binkul/Atari_130XE_1MB_SpartaDosX_SIO2SD/README.md

# Atari 130XE with 1MB simm expansion + Internal Sparta Dos X 64 kb + SIO2SD internal
## In folder '1 MB Extension' - schematic + jedec file for GAL 20V8
## In folder 'OS 29C512 or 29F010' - memory contents for Flash 29C512 or 29F010 => four OS (Atari 130XE 2x and Bibo OS 2x)
## In folder 'SD Card' - everything to run inregnal SD card. Read cerafully http://sio2sd.org/pl/index.html or similar
## In folder 'Sparta 64KB' - everything to program GAL 20V8 and Flash 29C512 or 29F010
