binkul/Atari_130XE_1MB_SpartaDosX_SIO2SD/1 MB Extension/simmexp.gif

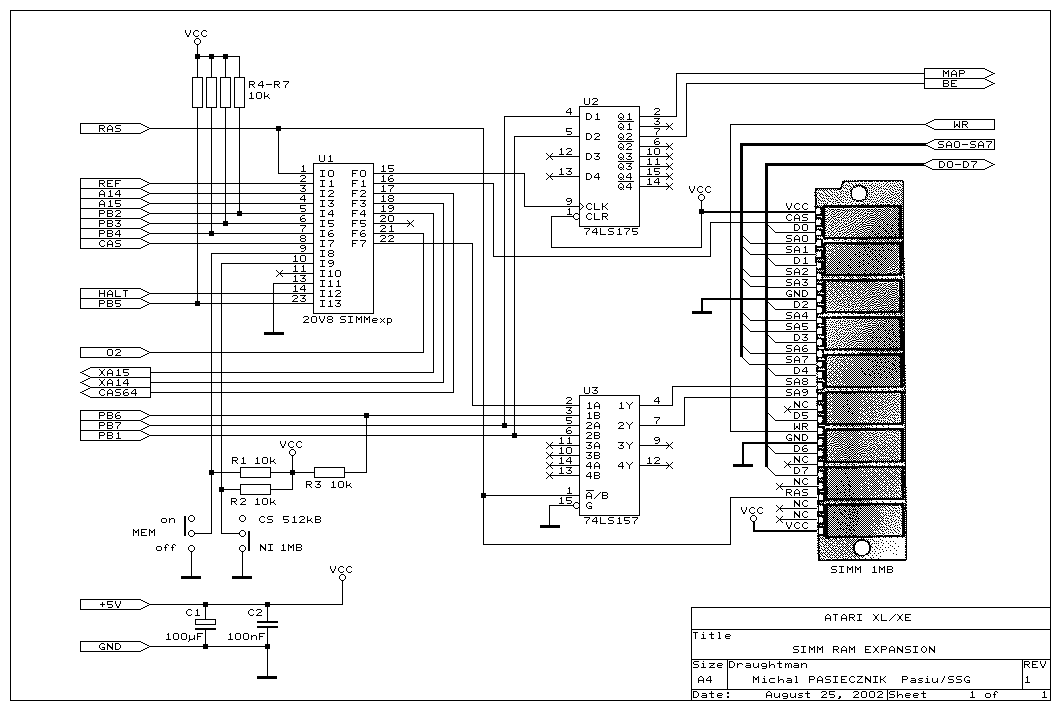
1 MB Extension/simmexp.gif
