binkul/Atari_130XE_1MB_SpartaDosX_SIO2SD/Sparta 64KB/intsdxv11.gif

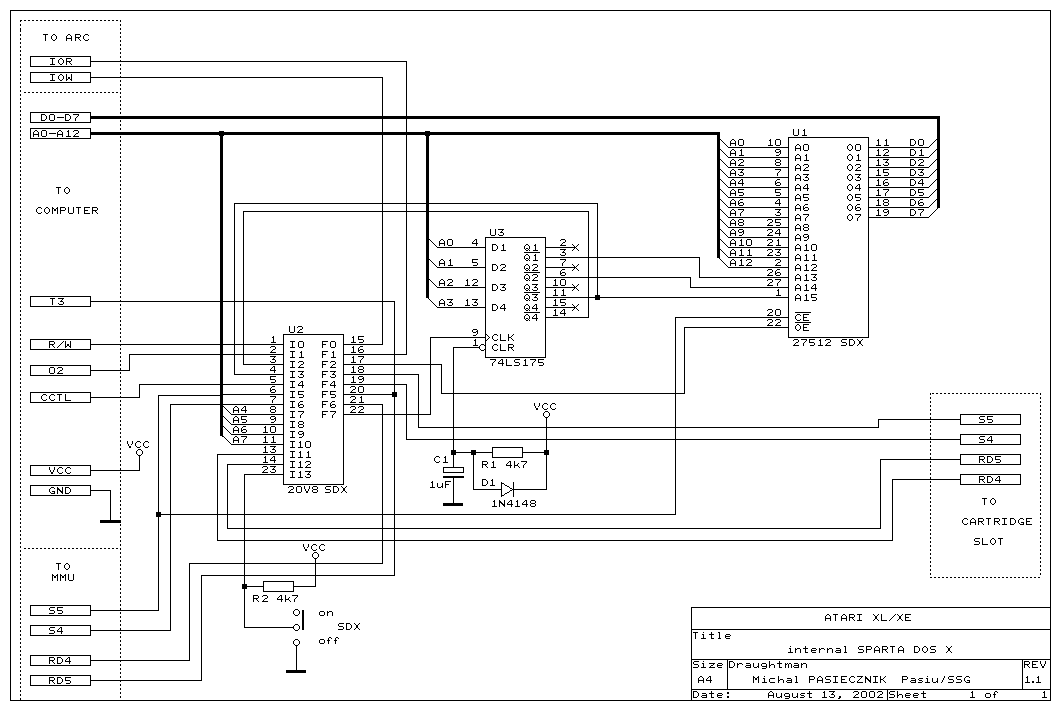
Sparta 64KB/intsdxv11.gif
