binkul/Atari_130XE_1MB_SpartaDosX_SIO2SD/Atari 130XE 1MB Sparta.kicad_pcb

## KiCad design Atari 130XE 1MB Sparta.kicad_pcb (2023-07-16)

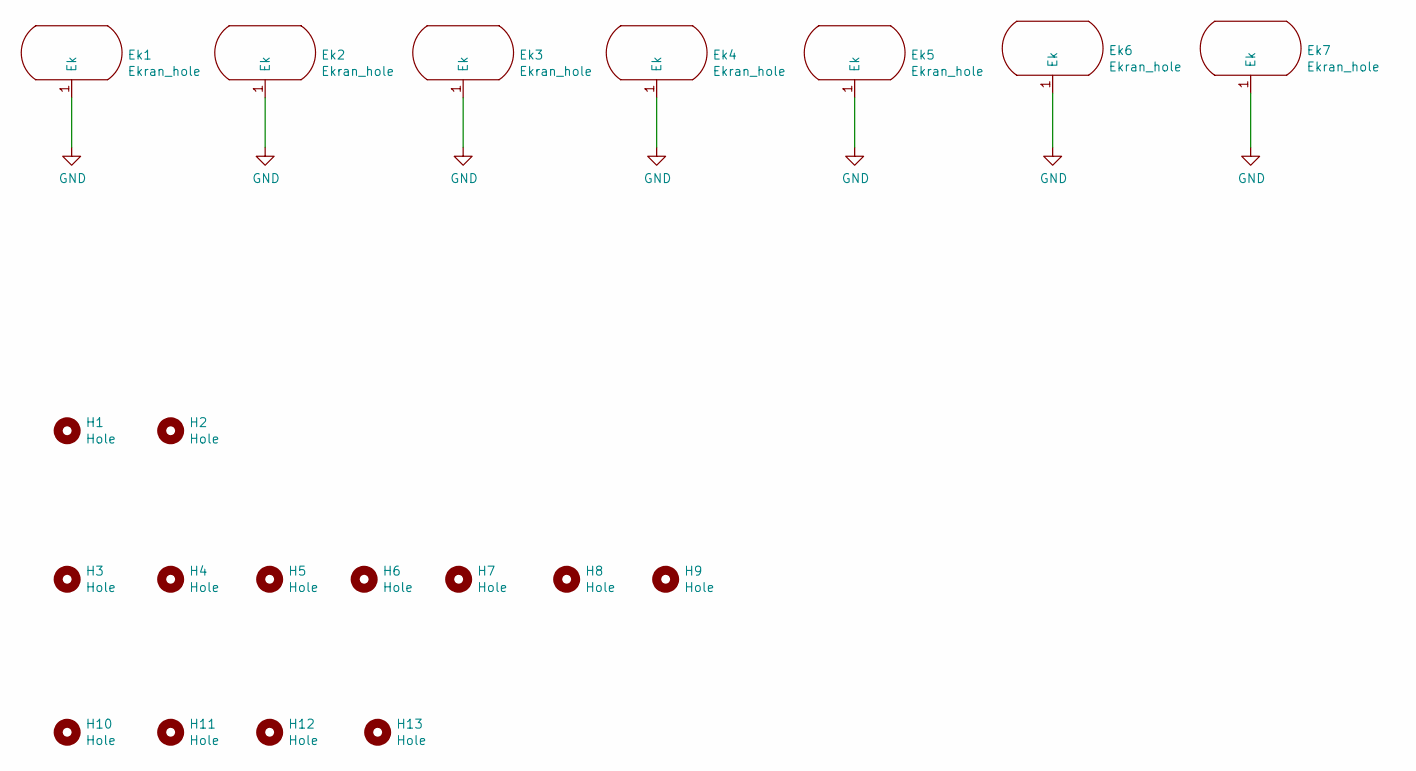
[picture p3: schematic Holes.sch]

Parts:
Ek1, Ek2, Ek3, Ek4, Ek5, Ek6, Ek7: Ekran_hole; Ekran_GND
H1, H2: Hole; Medium_hole
H3, H4, H5, H6, H7, H8, H9: Hole; Hole_3.4mm
H10, H11, H12, H13: Hole; Hole_4.4mm

Connections:
GND: Ek1.1, Ek2.1, Ek3.1, Ek4.1, Ek5.1, Ek6.1, Ek7.1; also elsewhere on the board

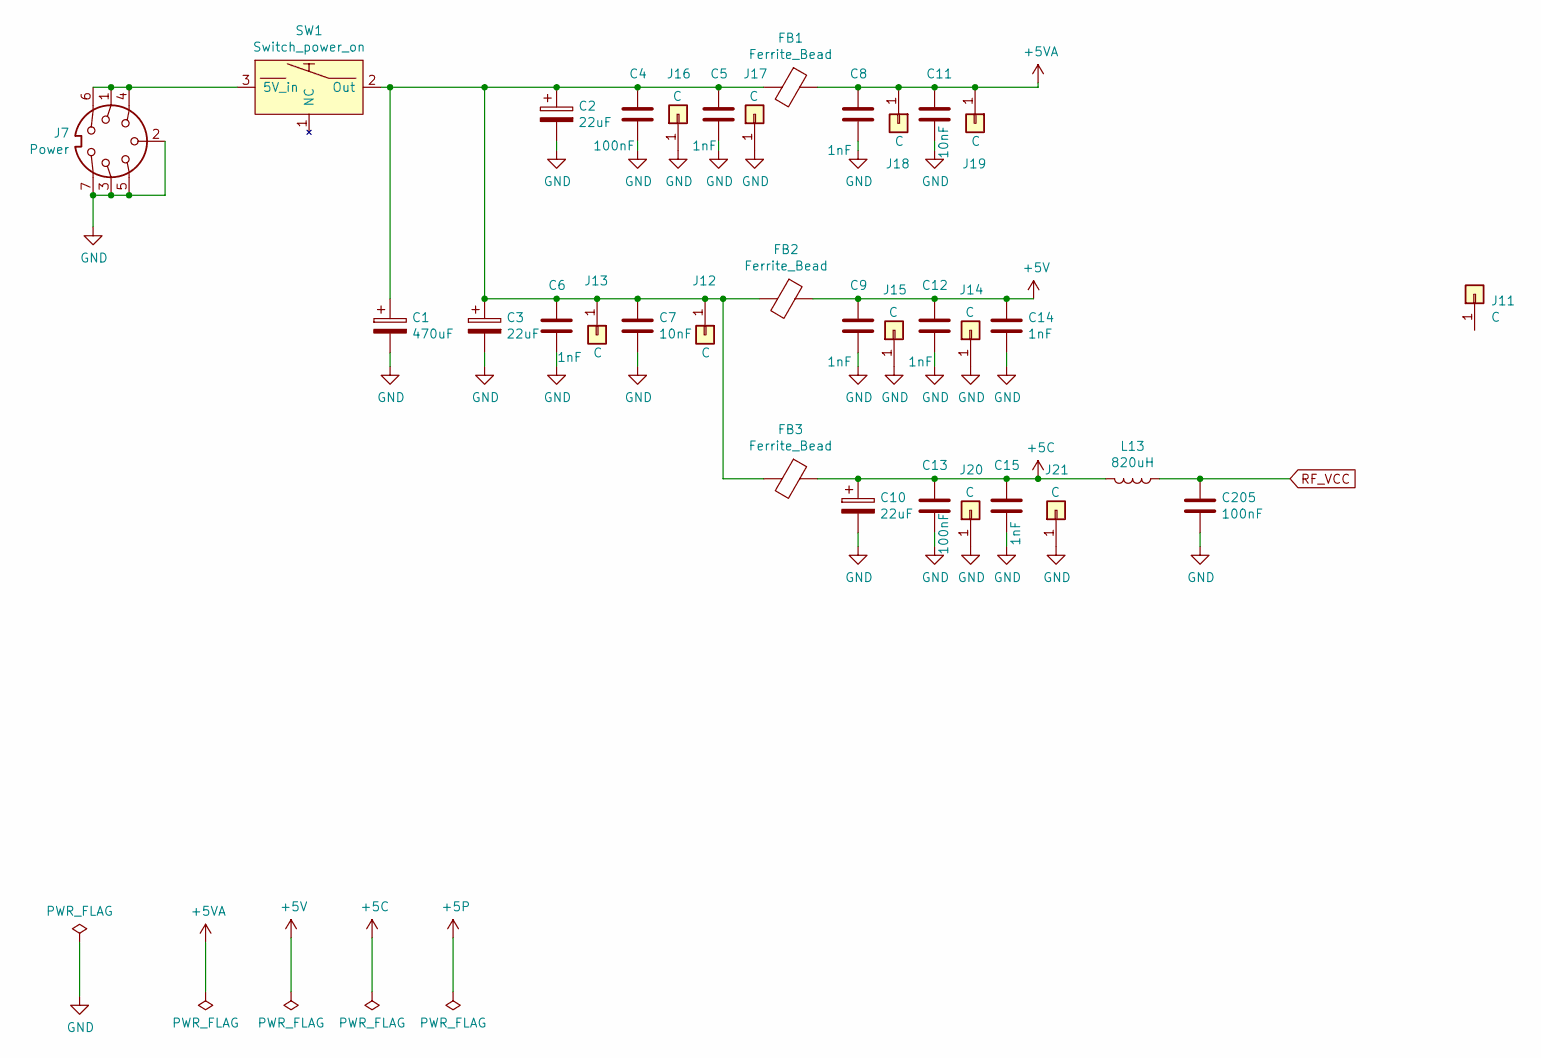
[picture p4: schematic Power.sch]

Parts:
C1: 470uF; CP_Radial_D8.0mm_P3.80mm
C2, C3, C10: 22uF; CP_Radial_D7.5mm_P2.50mm
C4, C13, C205: 100nF; C_Axial_L5.1mm_D2.5mm_P12.50mm_Horizontal
C5, C6, C8, C9, C12, C14, C15: 1nF; C_Axial_L5.1mm_D2.5mm_P12.50mm_Horizontal
C7, C11: 10nF; C_Axial_L5.1mm_D2.5mm_P12.50mm_Horizontal
FB1, FB2, FB3: Ferrite_Bead; L_Axial_L7.0mm_D3.3mm_P12.50mm_Horizontal_Fastron_MICC
J7: Power; DIN_7_pin
J11, J12, J13, J14, J15, J16, J17, J18, J19, J20, J21: C; PinHeader_1x01_P2.54mm_Vertical
L13: 820uH; L_Axial_L7.0mm_D3.3mm_P12.50mm_Horizontal_Fastron_MICC
SW1: Switch_power_on; Switch_ON-OFF

Connections:
+5C: C10.1, C13.1, C15.1, FB3.1, L13.2; also elsewhere on the board
+5V: C9.1, C12.1, C14.1, FB2.1
+5VA: C8.1, C11.1, FB1.1, J18.1, J19.1; also elsewhere on the board
GND: C1.2, C2.2, C3.2, C4.2, C5.2, C6.2, C7.2, C8.2, C9.2, C10.2, C11.2, C12.2, C13.2, C14.2, C15.2, C205.2, J7.2, J7.3, J7.5, J7.7, J14.1, J15.1, J16.1, J17.1, J20.1, J21.1; also elsewhere on the board
unnamed: C1.1, C2.1, C3.1, C4.1, C5.1, C6.1, C7.1, FB1.2, FB2.2, FB3.2, J12.1, J13.1, SW1.2 (Out)
unnamed: J7.1, J7.4, J7.6, SW1.3 (5V_in)
RF_VCC: C205.1, L13.1

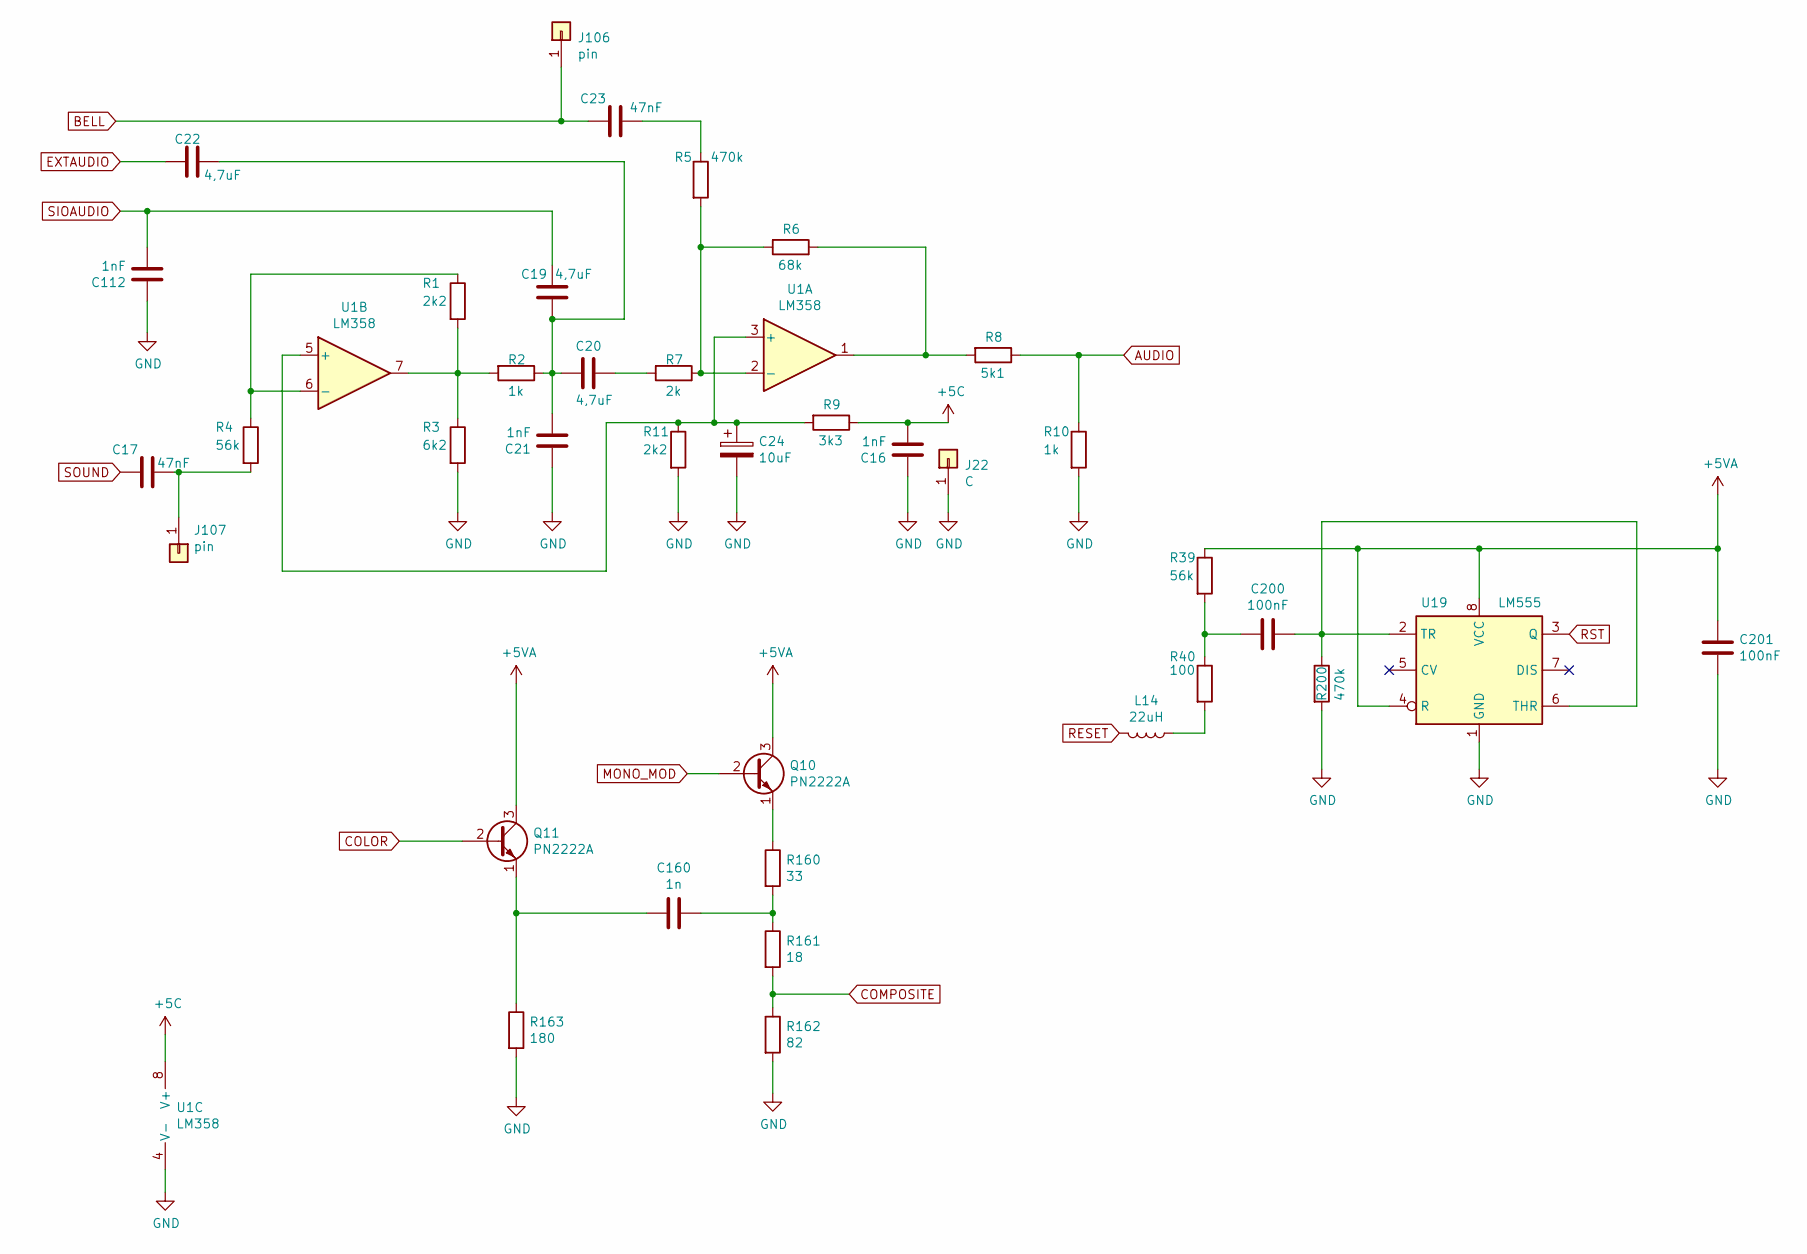
[picture p5: schematic Audio and Video.sch]

Parts:
C16, C21, C112: 1nF; C_Axial_L5.1mm_D2.5mm_P12.50mm_Horizontal
C17, C23: 47nF; C_Axial_L5.1mm_D2.5mm_P12.50mm_Horizontal
C19, C20, C22: 4,7uF; C_Rect_L7.2mm_W7.2mm_P5.00mm_FKS2_FKP2_MKS2_MKP2
C24: 10uF; CP_Radial_D7.5mm_P2.50mm
C160: 1n; C_1206_3216Metric_Pad1.42x1.75mm_HandSolder
C200, C201: 100nF; C_1206_3216Metric_Pad1.42x1.75mm_HandSolder
J22: C; PinHeader_1x01_P2.54mm_Vertical
J106, J107: pin; PinHeader_1x01_P2.00mm_Vertical
L14: 22uH; L_1812_4532Metric_Pad1.30x3.40mm_HandSolder
Q10, Q11: PN2222A; TO-92_Inline
R1, R11: 2k2; R_Axial_DIN0207_L3.6mm_D2.2mm_P10.16mm_Horizontal
R2, R10: 1k; R_Axial_DIN0207_L3.6mm_D2.2mm_P10.16mm_Horizontal
R3: 6k2; R_Axial_DIN0207_L3.6mm_D2.2mm_P10.16mm_Horizontal
R4: 56k; R_Axial_DIN0207_L3.6mm_D2.2mm_P10.16mm_Horizontal
R5: 470k; R_Axial_DIN0207_L3.6mm_D2.2mm_P10.16mm_Horizontal
R6: 68k; R_Axial_DIN0207_L3.6mm_D2.2mm_P10.16mm_Horizontal
R7: 2k; R_Axial_DIN0207_L3.6mm_D2.2mm_P10.16mm_Horizontal
R8: 5k1; R_Axial_DIN0207_L3.6mm_D2.2mm_P10.16mm_Horizontal
R9: 3k3; R_Axial_DIN0207_L3.6mm_D2.2mm_P10.16mm_Horizontal
R39: 56k; R_1206_3216Metric_Pad1.42x1.75mm_HandSolder
R40: 100; R_1206_3216Metric_Pad1.42x1.75mm_HandSolder
R160: 33; R_1206_3216Metric_Pad1.42x1.75mm_HandSolder
R161: 18; R_1206_3216Metric_Pad1.42x1.75mm_HandSolder
R162: 82; R_1206_3216Metric_Pad1.42x1.75mm_HandSolder
R163: 180; R_1206_3216Metric_Pad1.42x1.75mm_HandSolder
R200: 470k; R_1206_3216Metric_Pad1.42x1.75mm_HandSolder
U1: LM358; DIP-8_W7.62mm_Socket
U19: LM555; DIP-8_W7.62mm_Socket

Connections:
+5C: C16.2, R9.1, U1.8 (V+); also elsewhere on the board
+5VA: C201.1, Q10.3 (C), Q11.3 (C), R39.1, U19.4 (R), U19.8 (VCC); also elsewhere on the board
AUDIO: R8.1, R10.1; also elsewhere on the board
BELL: C23.2, J106.1; also elsewhere on the board
COLOR: Q11.2 (B); also elsewhere on the board
COMPOSITE: R161.2, R162.1; also elsewhere on the board
EXTAUDIO: C22.1; also elsewhere on the board
GND: C16.1, C21.1, C24.2, C112.1, C201.2, J22.1, R3.2, R10.2, R11.2, R162.2, R163.2, R200.2, U1.4 (V-), U19.1 (GND); also elsewhere on the board
MONO_MOD: Q10.2 (B); also elsewhere on the board
unnamed: C17.1, J107.1, R4.2
unnamed: C19.1, C20.2, C21.2, C22.2, R2.1
unnamed: C20.1, R7.2
unnamed: C23.1, R5.1
unnamed: C24.1, R9.2, R11.1, U1.3 (+), U1.5 (+)
unnamed: C160.1, R160.2, R161.1
unnamed: C160.2, Q11.1 (E), R163.1
unnamed: C200.1, R200.1, U19.2 (TR), U19.6 (THR)
unnamed: C200.2, R39.2, R40.1
unnamed: L14.1, R40.2
unnamed: Q10.1 (E), R160.1
unnamed: R1.1, R4.1, U1.6 (-)
unnamed: R1.2, R2.2, R3.1, U1.7
unnamed: R5.2, R6.2, R7.1, U1.2 (-)
unnamed: R6.1, R8.2, U1.1
RESET: L14.2; also elsewhere on the board
RST: U19.3 (Q); also elsewhere on the board
SIOAUDIO: C19.2, C112.2; also elsewhere on the board
SOUND: C17.2; also elsewhere on the board

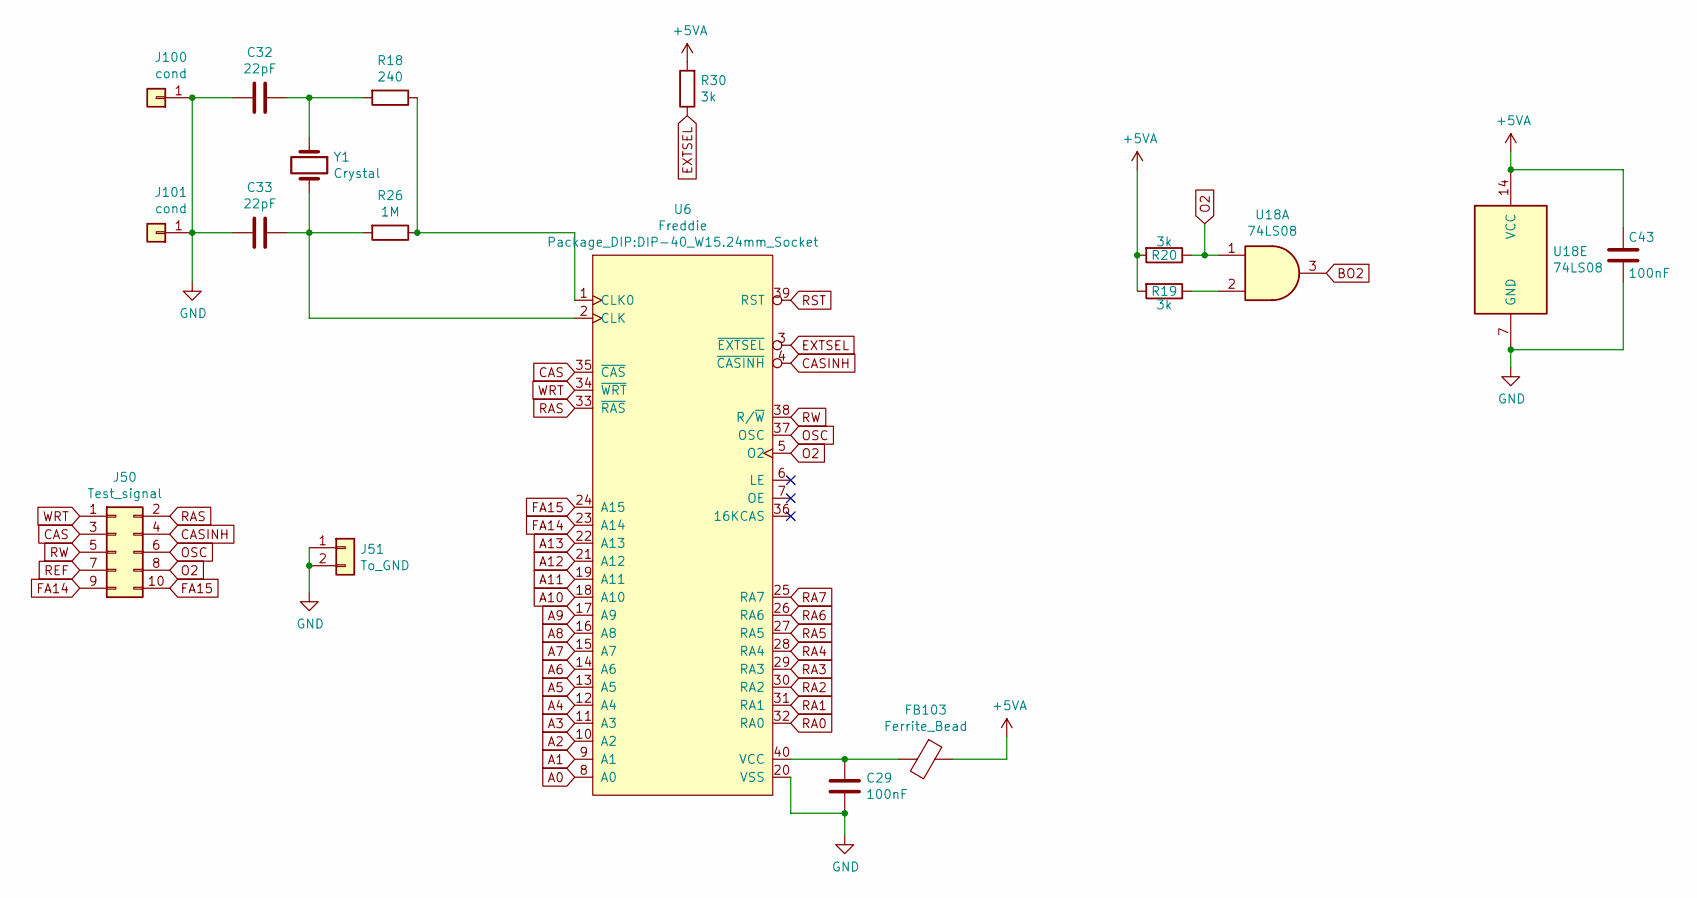
[picture p6: schematic Freddie.sch]

Parts:
C29, C43: 100nF; C_Axial_L5.1mm_D2.5mm_P12.50mm_Horizontal
C32, C33: 22pF; C_Axial_L5.1mm_D2.5mm_P12.50mm_Horizontal
FB103: Ferrite_Bead; L_Axial_L7.0mm_D3.3mm_P12.50mm_Horizontal_Fastron_MICC
J50: Test_signal; PinHeader_2x05_P2.54mm_Vertical
J51: To_GND; PinHeader_1x02_P2.54mm_Vertical
J100, J101: cond; PinHeader_1x01_P2.00mm_Vertical
R18: 240; R_Axial_DIN0207_L6.3mm_D2.5mm_P10.16mm_Horizontal
R19, R20, R30: 3k; R_Axial_DIN0207_L3.6mm_D2.2mm_P10.16mm_Horizontal
R26: 1M; R_Axial_DIN0207_L6.3mm_D2.5mm_P10.16mm_Horizontal
U6: Freddie; DIP-40_W15.24mm_Socket
U18: 74LS08; DIP-14_W7.62mm_Socket
Y1: Crystal; Crystal_HC18-U_Vertical

Connections:
+5VA: C43.1, FB103.1, R19.2, R20.2, R30.2, U18.14 (VCC); also elsewhere on the board
A0: U6.8 (A0); also elsewhere on the board
A1: U6.9 (A1); also elsewhere on the board
A2: U6.10 (A2); also elsewhere on the board
A3: U6.11 (A3); also elsewhere on the board
A4: U6.12 (A4); also elsewhere on the board
A5: U6.13 (A5); also elsewhere on the board
A6: U6.14 (A6); also elsewhere on the board
A7: U6.15 (A7); also elsewhere on the board
A8: U6.16 (A8); also elsewhere on the board
A9: U6.17 (A9); also elsewhere on the board
A10: U6.18 (A10); also elsewhere on the board
A11: U6.19 (A11); also elsewhere on the board
A12: U6.21 (A12); also elsewhere on the board
A13: U6.22 (A13); also elsewhere on the board
BO2: U18.3; also elsewhere on the board
CAS: J50.3, U6.35 (~CAS); also elsewhere on the board
CASINH: J50.4, U6.4 (~CASINH); also elsewhere on the board
EXTSEL: R30.1, U6.3 (~EXTSEL); also elsewhere on the board
FA14: J50.9, U6.23 (A14); also elsewhere on the board
FA15: J50.10, U6.24 (A15); also elsewhere on the board
GND: C29.2, C32.2, C33.2, C43.2, J51.1, J51.2, J100.1, J101.1, U6.20 (VSS), U18.7 (GND); also elsewhere on the board
unnamed: C29.1, FB103.2, U6.40 (VCC)
unnamed: C32.1, R18.2, Y1.1
unnamed: C33.1, R26.2, U6.2 (CLK), Y1.2
unnamed: R18.1, R26.1, U6.1 (CLK0)
unnamed: R19.1, U18.2
O2: J50.8, R20.1, U6.5 (O2), U18.1; also elsewhere on the board
OSC: J50.6, U6.37 (OSC); also elsewhere on the board
RA0: U6.32 (RA0); also elsewhere on the board
RA1: U6.31 (RA1); also elsewhere on the board
RA2: U6.30 (RA2); also elsewhere on the board
RA3: U6.29 (RA3); also elsewhere on the board
RA4: U6.28 (RA4); also elsewhere on the board
RA5: U6.27 (RA5); also elsewhere on the board
RA6: U6.26 (RA6); also elsewhere on the board
RA7: U6.25 (RA7); also elsewhere on the board
RAS: J50.2, U6.33 (~RAS); also elsewhere on the board
REF: J50.7; also elsewhere on the board
RST: U6.39 (RST); also elsewhere on the board
RW: J50.5, U6.38 (R/~W); also elsewhere on the board
WRT: J50.1, U6.34 (~WRT); also elsewhere on the board

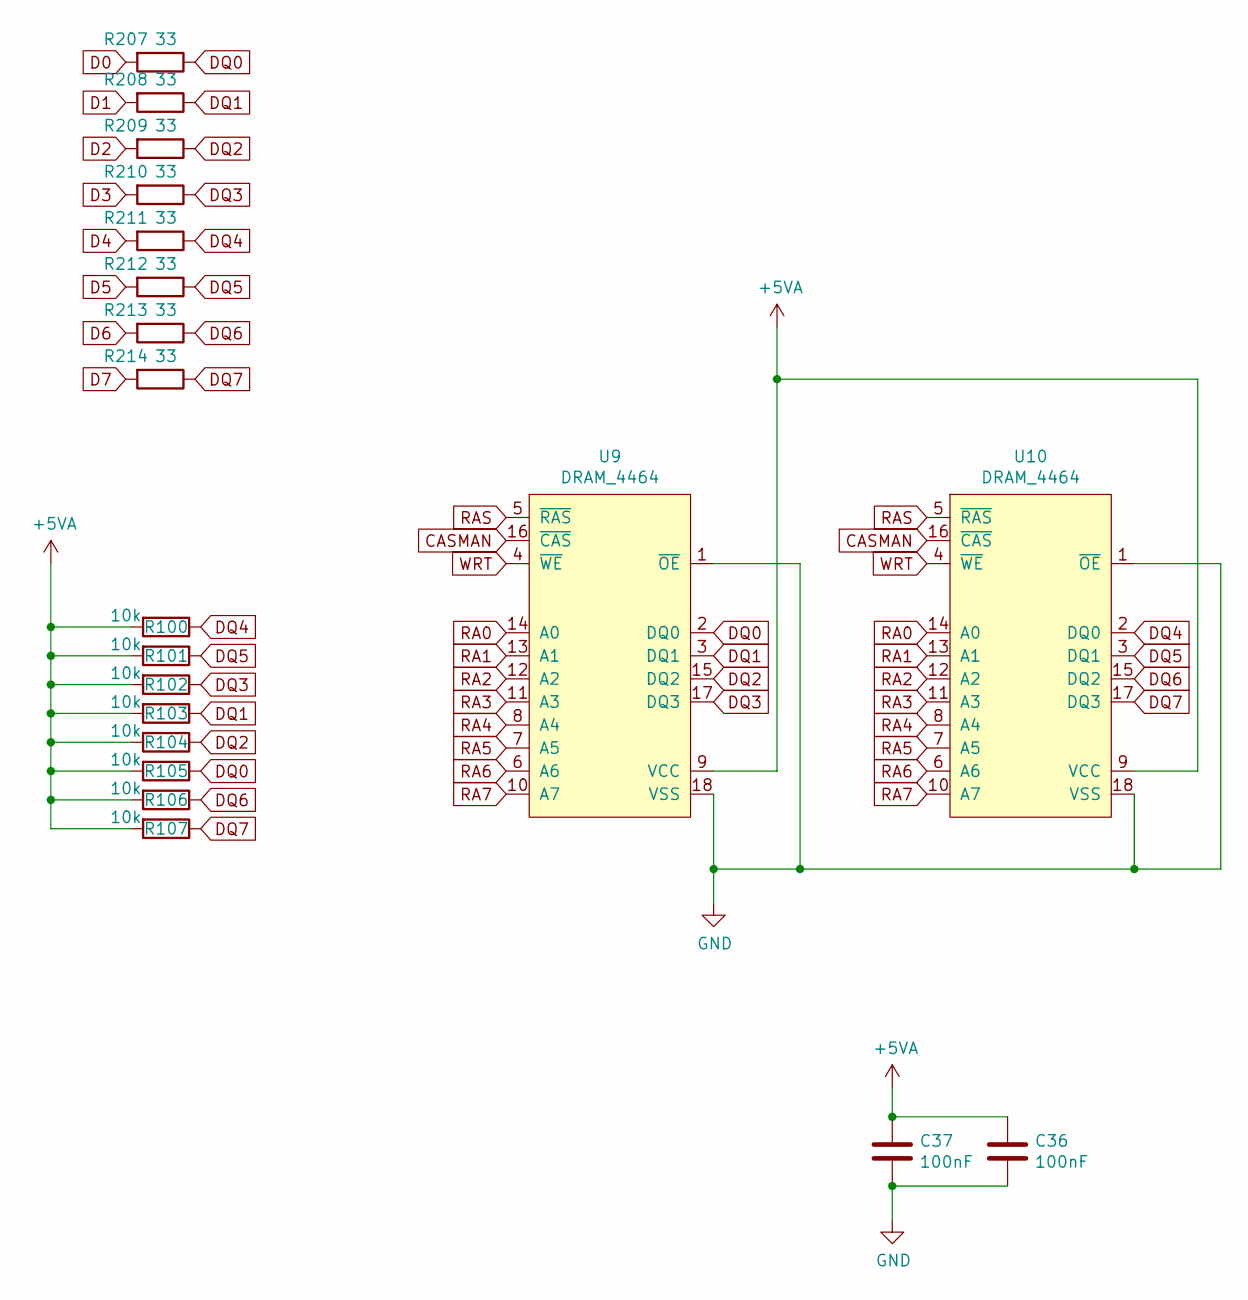
[picture p7: schematic Memory.sch]

Parts:
C36, C37: 100nF; C_Axial_L3.8mm_D2.6mm_P7.50mm_Horizontal
R100, R101, R102, R103, R104, R105, R106, R107: 10k; R_Axial_DIN0207_L3.6mm_D2.2mm_P10.16mm_Horizontal
R207, R208, R209, R210, R211, R212, R213, R214: 33; R_Axial_DIN0207_L3.6mm_D2.2mm_P10.16mm_Horizontal
U9, U10: DRAM_4464; DIP-18_W7.62mm

Connections:
+5VA: C36.1, C37.1, R100.2, R101.2, R102.2, R103.2, R104.2, R105.2, R106.2, R107.2, U9.9 (VCC), U10.9 (VCC); also elsewhere on the board
CASMAN: U9.16 (~CAS), U10.16 (~CAS); also elsewhere on the board
D0: R207.2; also elsewhere on the board
D1: R208.2; also elsewhere on the board
D2: R209.2; also elsewhere on the board
D3: R210.2; also elsewhere on the board
D4: R211.2; also elsewhere on the board
D5: R212.2; also elsewhere on the board
D6: R213.2; also elsewhere on the board
D7: R214.2; also elsewhere on the board
DQ0: R105.1, R207.1, U9.2 (DQ0); also elsewhere on the board
DQ1: R103.1, R208.1, U9.3 (DQ1); also elsewhere on the board
DQ2: R104.1, R209.1, U9.15 (DQ2); also elsewhere on the board
DQ3: R102.1, R210.1, U9.17 (DQ3); also elsewhere on the board
DQ4: R100.1, R211.1, U10.2 (DQ0); also elsewhere on the board
DQ5: R101.1, R212.1, U10.3 (DQ1); also elsewhere on the board
DQ6: R106.1, R213.1, U10.15 (DQ2); also elsewhere on the board
DQ7: R107.1, R214.1, U10.17 (DQ3); also elsewhere on the board
GND: C36.2, C37.2, U9.1 (~OE), U9.18 (VSS), U10.1 (~OE), U10.18 (VSS); also elsewhere on the board
RA0: U9.14 (A0), U10.14 (A0); also elsewhere on the board
RA1: U9.13 (A1), U10.13 (A1); also elsewhere on the board
RA2: U9.12 (A2), U10.12 (A2); also elsewhere on the board
RA3: U9.11 (A3), U10.11 (A3); also elsewhere on the board
RA4: U9.8 (A4), U10.8 (A4); also elsewhere on the board
RA5: U9.7 (A5), U10.7 (A5); also elsewhere on the board
RA6: U9.6 (A6), U10.6 (A6); also elsewhere on the board
RA7: U9.10 (A7), U10.10 (A7); also elsewhere on the board
RAS: U9.5 (~RAS), U10.5 (~RAS); also elsewhere on the board
WRT: U9.4 (~WE), U10.4 (~WE); also elsewhere on the board

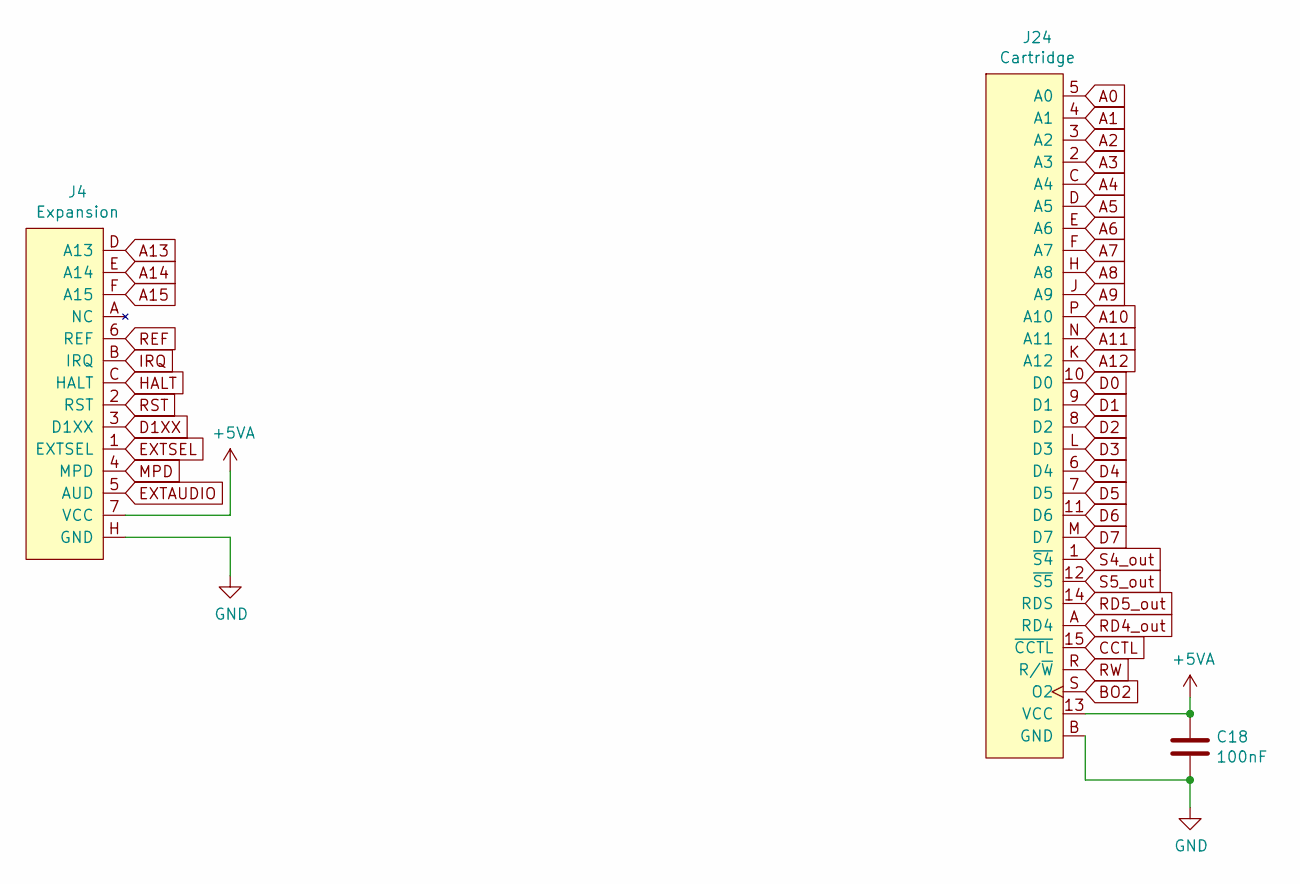
[picture p8: schematic Cartridge.sch]

Parts:
C18: 100nF; C_Axial_L5.1mm_D2.5mm_P12.50mm_Horizontal
J4: Expansion; Expansion_Slot
J24: Cartridge; Cartridge_Slot

Connections:
+5VA: C18.1, J4.7 (VCC), J24.13 (VCC); also elsewhere on the board
A0: J24.5 (A0); also elsewhere on the board
A1: J24.4 (A1); also elsewhere on the board
A2: J24.3 (A2); also elsewhere on the board
A3: J24.2 (A3); also elsewhere on the board
A4: J24.C (A4); also elsewhere on the board
A5: J24.D (A5); also elsewhere on the board
A6: J24.E (A6); also elsewhere on the board
A7: J24.F (A7); also elsewhere on the board
A8: J24.H (A8); also elsewhere on the board
A9: J24.J (A9); also elsewhere on the board
A10: J24.P (A10); also elsewhere on the board
A11: J24.N (A11); also elsewhere on the board
A12: J24.K (A12); also elsewhere on the board
A13: J4.D (A13); also elsewhere on the board
A14: J4.E (A14); also elsewhere on the board
A15: J4.F (A15); also elsewhere on the board
BO2: J24.S (O2); also elsewhere on the board
CCTL: J24.15 (~CCTL); also elsewhere on the board
D0: J24.10 (D0); also elsewhere on the board
D1: J24.9 (D1); also elsewhere on the board
D1XX: J4.3 (D1XX); also elsewhere on the board
D2: J24.8 (D2); also elsewhere on the board
D3: J24.L (D3); also elsewhere on the board
D4: J24.6 (D4); also elsewhere on the board
D5: J24.7 (D5); also elsewhere on the board
D6: J24.11 (D6); also elsewhere on the board
D7: J24.M (D7); also elsewhere on the board
EXTAUDIO: J4.5 (AUD); also elsewhere on the board
EXTSEL: J4.1 (EXTSEL); also elsewhere on the board
GND: C18.2, J4.H (GND), J24.B (GND); also elsewhere on the board
HALT: J4.C (HALT); also elsewhere on the board
IRQ: J4.B (IRQ); also elsewhere on the board
MPD: J4.4 (MPD); also elsewhere on the board
RD4_out: J24.A (RD4); also elsewhere on the board
RD5_out: J24.14 (RDS); also elsewhere on the board
REF: J4.6 (REF); also elsewhere on the board
RST: J4.2 (RST); also elsewhere on the board
RW: J24.R (R/~W); also elsewhere on the board
S4_out: J24.1 (~S4); also elsewhere on the board
S5_out: J24.12 (~S5); also elsewhere on the board

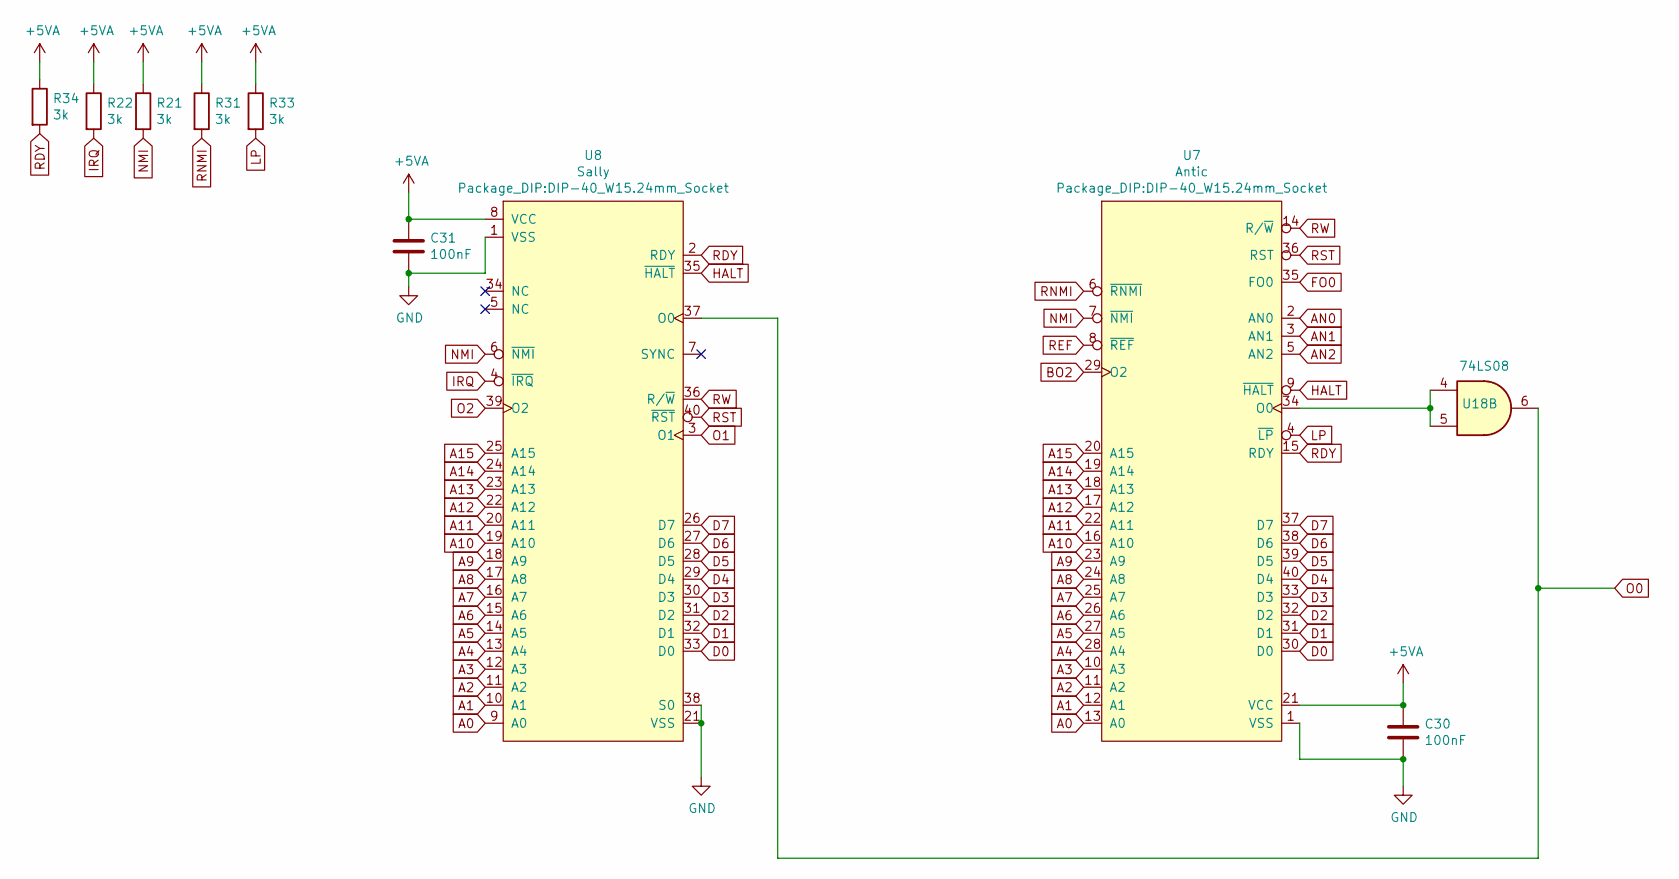
[picture p9: schematic Sally_Antic.sch]

Parts:
C30, C31: 100nF; C_Axial_L5.1mm_D2.5mm_P12.50mm_Horizontal
R21, R22, R31, R33, R34: 3k; R_Axial_DIN0207_L3.6mm_D2.2mm_P10.16mm_Horizontal
U7: Antic; DIP-40_W15.24mm_Socket
U8: Sally; DIP-40_W15.24mm_Socket
U18: 74LS08; DIP-14_W7.62mm_Socket

Connections:
+5VA: C30.1, C31.1, R21.1, R22.1, R31.1, R33.1, R34.1, U7.21 (VCC), U8.8 (VCC); also elsewhere on the board
A0: U7.13 (A0), U8.9 (A0); also elsewhere on the board
A1: U7.12 (A1), U8.10 (A1); also elsewhere on the board
A2: U7.11 (A2), U8.11 (A2); also elsewhere on the board
A3: U7.10 (A3), U8.12 (A3); also elsewhere on the board
A4: U7.28 (A4), U8.13 (A4); also elsewhere on the board
A5: U7.27 (A5), U8.14 (A5); also elsewhere on the board
A6: U7.26 (A6), U8.15 (A6); also elsewhere on the board
A7: U7.25 (A7), U8.16 (A7); also elsewhere on the board
A8: U7.24 (A8), U8.17 (A8); also elsewhere on the board
A9: U7.23 (A9), U8.18 (A9); also elsewhere on the board
A10: U7.16 (A10), U8.19 (A10); also elsewhere on the board
A11: U7.22 (A11), U8.20 (A11); also elsewhere on the board
A12: U7.17 (A12), U8.22 (A12); also elsewhere on the board
A13: U7.18 (A13), U8.23 (A13); also elsewhere on the board
A14: U7.19 (A14), U8.24 (A14); also elsewhere on the board
A15: U7.20 (A15), U8.25 (A15); also elsewhere on the board
AN0: U7.2 (AN0); also elsewhere on the board
AN1: U7.3 (AN1); also elsewhere on the board
AN2: U7.5 (AN2); also elsewhere on the board
BO2: U7.29 (O2); also elsewhere on the board
D0: U7.30 (D0), U8.33 (D0); also elsewhere on the board
D1: U7.31 (D1), U8.32 (D1); also elsewhere on the board
D2: U7.32 (D2), U8.31 (D2); also elsewhere on the board
D3: U7.33 (D3), U8.30 (D3); also elsewhere on the board
D4: U7.40 (D4), U8.29 (D4); also elsewhere on the board
D5: U7.39 (D5), U8.28 (D5); also elsewhere on the board
D6: U7.38 (D6), U8.27 (D6); also elsewhere on the board
D7: U7.37 (D7), U8.26 (D7); also elsewhere on the board
FO0: U7.35 (FO0); also elsewhere on the board
GND: C30.2, C31.2, U7.1 (VSS), U8.1 (VSS), U8.21 (VSS), U8.38 (S0); also elsewhere on the board
HALT: U7.9 (~HALT), U8.35 (~HALT); also elsewhere on the board
IRQ: R22.2, U8.4 (~IRQ); also elsewhere on the board
LP: R33.2, U7.4 (~LP); also elsewhere on the board
NMI: R21.2, U7.7 (~NMI), U8.6 (~NMI)
unnamed: U7.34 (O0), U18.4, U18.5
O0: U8.37 (O0), U18.6
O1: U8.3 (O1); also elsewhere on the board
O2: U8.39 (O2); also elsewhere on the board
RDY: R34.2, U7.15 (RDY), U8.2 (RDY)
REF: U7.8 (~REF); also elsewhere on the board
RNMI: R31.2, U7.6 (~RNMI)
RST: U7.36 (RST), U8.40 (~RST); also elsewhere on the board
RW: U7.14 (R/~W), U8.36 (R/~W); also elsewhere on the board
