binkul/Atari_130XE_1MB_SpartaDosX_SIO2SD/Atari 130XE 1MB Sparta.kicad_pcb

## KiCad design Atari 130XE 1MB Sparta.kicad_pcb (continued)

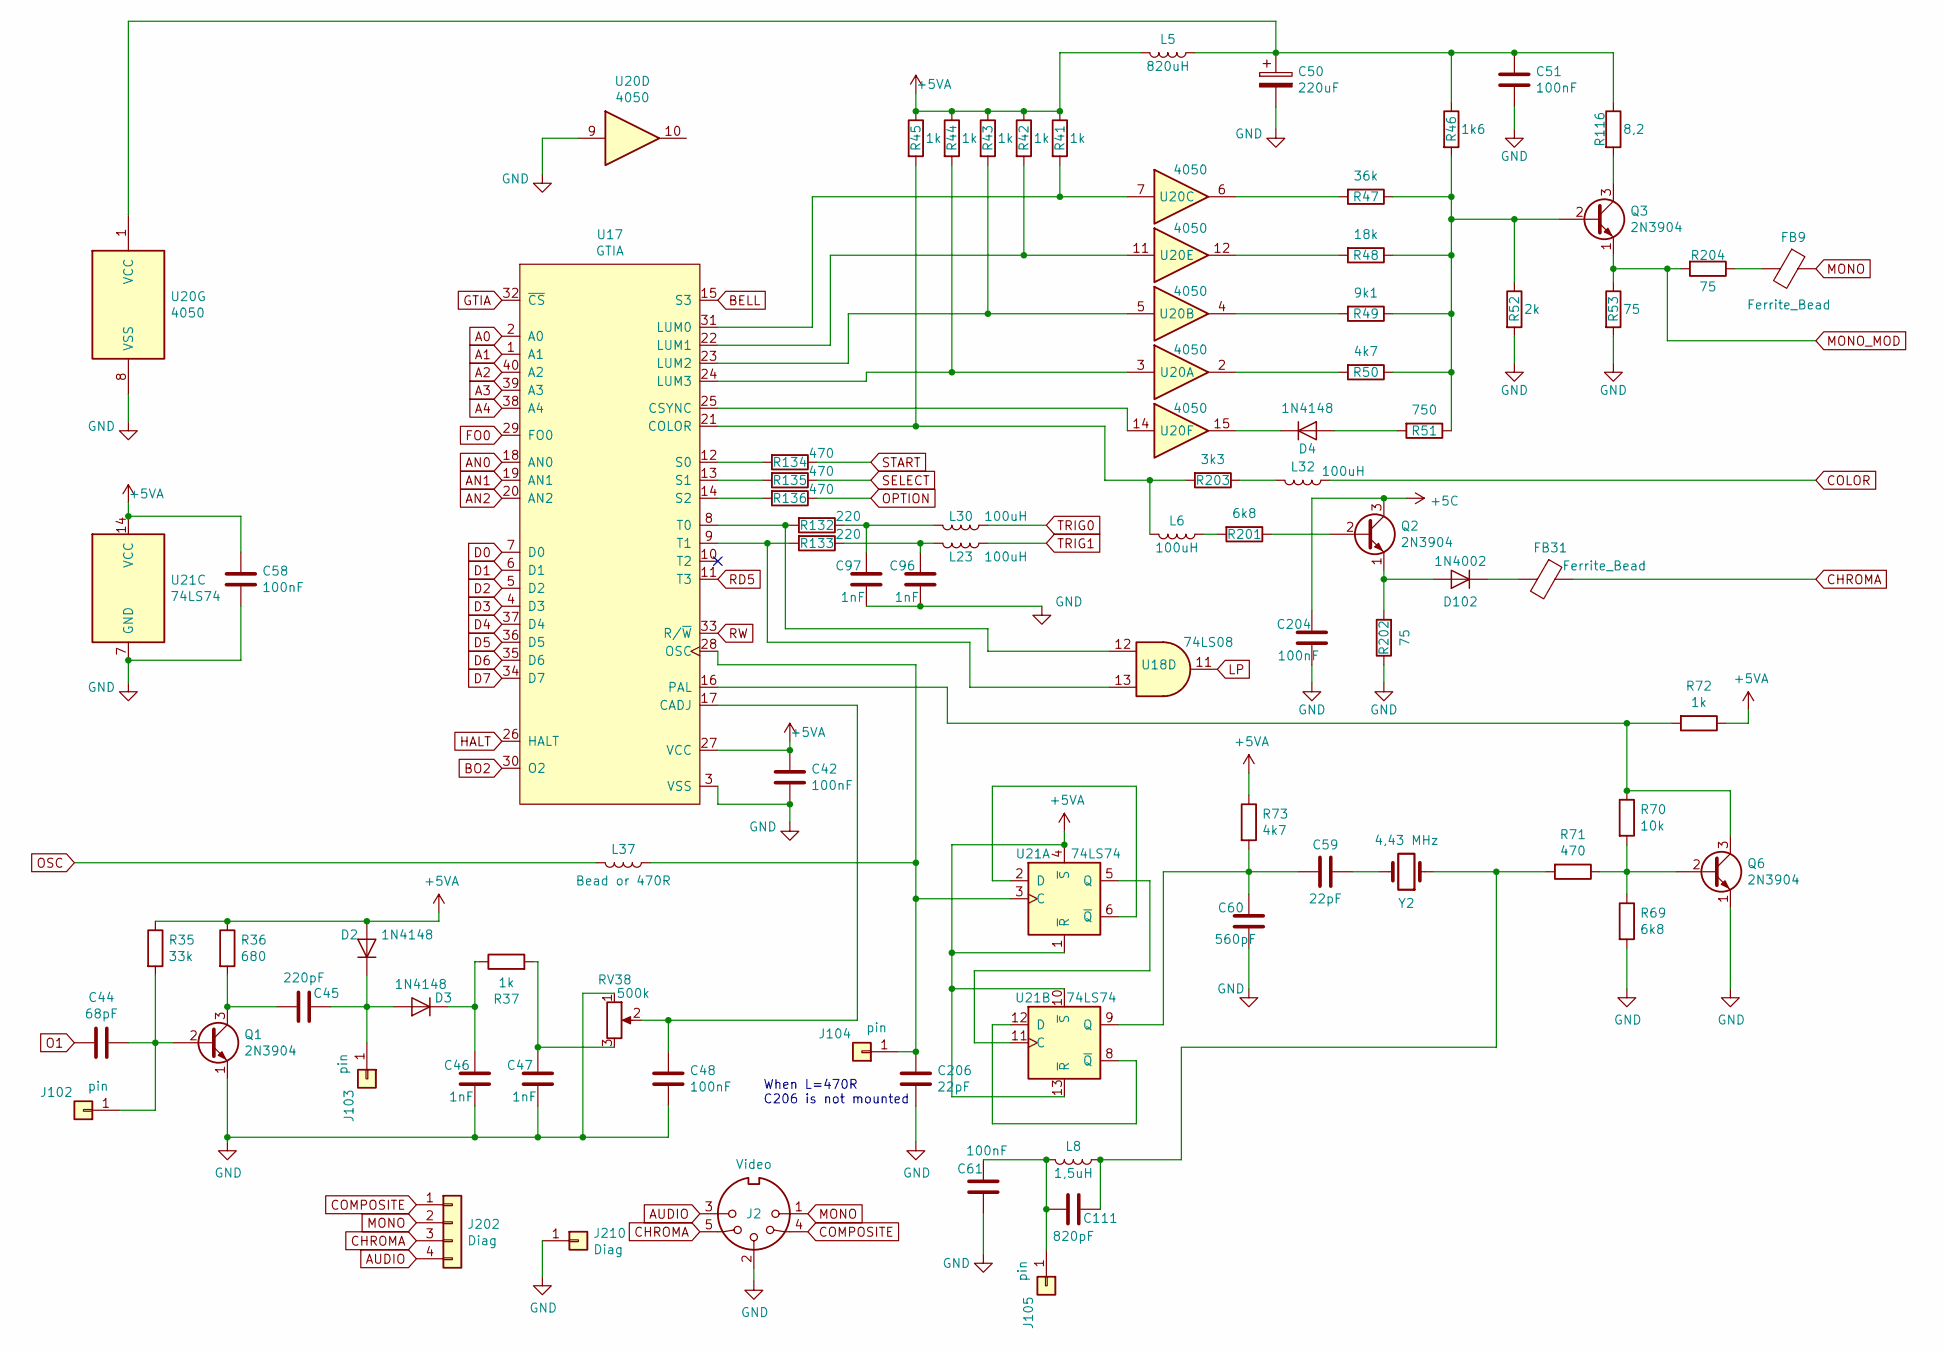
[picture p10: schematic GTIA.sch]

Parts:
C42, C48, C51, C58, C61, C204: 100nF; C_Axial_L5.1mm_D2.5mm_P12.50mm_Horizontal
C44: 68pF; C_Axial_L5.1mm_D2.5mm_P12.50mm_Horizontal
C45: 220pF; C_Axial_L5.1mm_D2.5mm_P12.50mm_Horizontal
C46, C47, C96, C97: 1nF; C_Axial_L5.1mm_D2.5mm_P12.50mm_Horizontal
C50: 220uF; CP_Radial_D5.0mm_P2.00mm
C59, C206: 22pF; C_Axial_L5.1mm_D2.5mm_P12.50mm_Horizontal
C60: 560pF; C_Axial_L5.1mm_D2.5mm_P12.50mm_Horizontal
C111: 820pF; C_Axial_L5.1mm_D2.5mm_P12.50mm_Horizontal
D2, D3, D4: 1N4148; D_DO-35_SOD27_P12.70mm_Horizontal
D102: 1N4002; R_Axial_DIN0207_L3.6mm_D2.2mm_P10.16mm_Horizontal
FB9, FB31: Ferrite_Bead; L_Axial_L7.0mm_D3.3mm_P12.50mm_Horizontal_Fastron_MICC
J2: Video; DIN_5_pin
J102, J103, J104, J105: pin; PinHeader_1x01_P2.00mm_Vertical
J202: Diag; PinHeader_1x04_P2.54mm_Vertical
J210: Diag; PinHeader_1x01_P2.54mm_Vertical
L5: 820uH; L_Axial_L7.0mm_D3.3mm_P12.50mm_Horizontal_Fastron_MICC
L6, L23, L30, L32: 100uH; L_Axial_L7.0mm_D3.3mm_P12.50mm_Horizontal_Fastron_MICC
L8: 1,5uH; L_Axial_L7.0mm_D3.3mm_P12.50mm_Horizontal_Fastron_MICC
L37: Bead or 470R; L_Axial_L7.0mm_D3.3mm_P12.50mm_Horizontal_Fastron_MICC
Q1, Q2, Q3: 2N3904; TO-92L_Wide
Q6: 2N3904; TO-92
R35: 33k; R_Axial_DIN0207_L3.6mm_D2.2mm_P10.16mm_Horizontal
R36: 680; R_Axial_DIN0207_L3.6mm_D2.2mm_P10.16mm_Horizontal
R37, R41, R42, R43, R44, R45, R72: 1k; R_Axial_DIN0207_L3.6mm_D2.2mm_P10.16mm_Horizontal
R46: 1k6; R_Axial_DIN0207_L3.6mm_D2.2mm_P10.16mm_Horizontal
R47: 36k; R_Axial_DIN0207_L3.6mm_D2.2mm_P10.16mm_Horizontal
R48: 18k; R_Axial_DIN0207_L3.6mm_D2.2mm_P10.16mm_Horizontal
R49: 9k1; R_Axial_DIN0207_L3.6mm_D2.2mm_P10.16mm_Horizontal
R50, R73: 4k7; R_Axial_DIN0207_L3.6mm_D2.2mm_P10.16mm_Horizontal
R51: 750; R_Axial_DIN0207_L3.6mm_D2.2mm_P10.16mm_Horizontal
R52: 2k; R_Axial_DIN0207_L3.6mm_D2.2mm_P10.16mm_Horizontal
R53, R202, R204: 75; R_Axial_DIN0207_L3.6mm_D2.2mm_P10.16mm_Horizontal
R69, R201: 6k8; R_Axial_DIN0207_L3.6mm_D2.2mm_P10.16mm_Horizontal
R70: 10k; R_Axial_DIN0207_L3.6mm_D2.2mm_P10.16mm_Horizontal
R71: 470; R_Axial_DIN0207_L3.6mm_D2.2mm_P10.16mm_Horizontal
R116: 8,2; R_Axial_DIN0207_L3.6mm_D2.2mm_P10.16mm_Horizontal
R132, R133: 220; R_Axial_DIN0207_L3.6mm_D2.2mm_P10.16mm_Horizontal
R134, R135, R136: 470; R_1206_3216Metric_Pad1.42x1.75mm_HandSolder
R203: 3k3; R_Axial_DIN0207_L3.6mm_D2.2mm_P10.16mm_Horizontal
RV38: 500k; Potentiometer_ACP_CA9-V10_Vertical_Hole
U17: GTIA; DIP-40_W15.24mm_Socket
U18: 74LS08; DIP-14_W7.62mm_Socket
U20: 4050; DIP-16_W7.62mm_Socket
U21: 74LS74; DIP-14_W7.62mm_Socket
Y2: 4,43 MHz; Crystal_HC18-U_Horizontal

Connections:
+5C: C204.2, Q2.3 (C); also elsewhere on the board
+5VA: C42.1, C58.1, D2.2 (A), L5.2, R35.1, R36.1, R41.1, R42.1, R43.1, R44.1, R45.1, R72.1, R73.1, U17.27 (VCC), U21.1 (~R), U21.4 (~S), U21.10 (~S), U21.13 (~R), U21.14 (VCC); also elsewhere on the board
A0: U17.2 (A0); also elsewhere on the board
A1: U17.1 (A1); also elsewhere on the board
A2: U17.40 (A2); also elsewhere on the board
A3: U17.39 (A3); also elsewhere on the board
A4: U17.38 (A4); also elsewhere on the board
AN0: U17.18 (AN0); also elsewhere on the board
AN1: U17.19 (AN1); also elsewhere on the board
AN2: U17.20 (AN2); also elsewhere on the board
AUDIO: J2.3, J202.4; also elsewhere on the board
BELL: U17.15 (S3); also elsewhere on the board
BO2: U17.30 (O2); also elsewhere on the board
CHROMA: FB31.1, J2.5, J202.3
COLOR: L32.1; also elsewhere on the board
COMPOSITE: J2.4, J202.1; also elsewhere on the board
D0: U17.7 (D0); also elsewhere on the board
D1: U17.6 (D1); also elsewhere on the board
D2: U17.5 (D2); also elsewhere on the board
D3: U17.4 (D3); also elsewhere on the board
D4: U17.37 (D4); also elsewhere on the board
D5: U17.36 (D5); also elsewhere on the board
D6: U17.35 (D6); also elsewhere on the board
D7: U17.34 (D7); also elsewhere on the board
FO0: U17.29 (FO0); also elsewhere on the board
GND: C42.2, C46.1, C47.1, C48.1, C50.2, C51.2, C58.2, C60.1, C61.1, C96.1, C97.1, C204.1, C206.1, J2.2, J210.1, Q1.1 (E), Q6.1 (E), R52.2, R53.2, R69.2, R202.1, RV38.1, U17.3 (VSS), U20.8 (VSS), U20.9, U21.7 (GND); also elsewhere on the board
GTIA: U17.32 (~CS); also elsewhere on the board
HALT: U17.26 (HALT); also elsewhere on the board
LP: U18.11; also elsewhere on the board
MONO: FB9.1, J2.1, J202.2
MONO_MOD: Q3.1 (E), R53.1, R204.2; also elsewhere on the board
unnamed: C44.1, J102.1, Q1.2 (B), R35.2
unnamed: C45.1, D2.1 (K), D3.2 (A), J103.1
unnamed: C45.2, Q1.3 (C), R36.2
unnamed: C46.2, D3.1 (K), R37.1
unnamed: C47.2, R37.2, RV38.3
unnamed: C48.2, RV38.2, U17.17 (CADJ)
unnamed: C50.1, C51.1, L5.1, R46.1, R116.1, U20.1 (VCC)
unnamed: C59.1, C60.2, R73.2, U21.9 (Q)
unnamed: C59.2, Y2.2
unnamed: C96.2, L23.2, R133.1
unnamed: C97.2, L30.2, R132.1
unnamed: C111.1, L8.1, R71.2, Y2.1
unnamed: C61.2, C111.2, J105.1, L8.2
unnamed: C206.2, J104.1, L37.1, U17.28 (OSC), U21.3 (C)
unnamed: D4.1 (K), U20.15
unnamed: D4.2 (A), R51.2
unnamed: D102.1 (K), FB31.2
unnamed: D102.2 (A), Q2.1 (E), R202.2
unnamed: FB9.2, R204.1
unnamed: L6.1, R201.2
unnamed: L6.2, R45.2, R203.2, U17.21 (COLOR)
unnamed: L32.2, R203.1
unnamed: Q2.2 (B), R201.1
unnamed: Q3.2 (B), R46.2, R47.1, R48.1, R49.1, R50.1, R51.1, R52.1
unnamed: Q3.3 (C), R116.2
unnamed: Q6.2 (B), R69.1, R70.2, R71.1
unnamed: Q6.3 (C), R70.1, R72.2, U17.16 (PAL)
unnamed: R41.2, U17.31 (LUM0), U20.7
unnamed: R42.2, U17.22 (LUM1), U20.11
unnamed: R43.2, U17.23 (LUM2), U20.5
unnamed: R44.2, U17.24 (LUM3), U20.3
unnamed: R47.2, U20.6
unnamed: R48.2, U20.12
unnamed: R49.2, U20.4
unnamed: R50.2, U20.2
unnamed: R132.2, U17.8 (T0), U18.12
unnamed: R133.2, U17.9 (T1), U18.13
unnamed: R134.2, U17.12 (S0)
unnamed: R135.2, U17.13 (S1)
unnamed: R136.2, U17.14 (S2)
unnamed: U17.25 (CSYNC), U20.14
unnamed: U21.2 (D), U21.6 (~Q)
unnamed: U21.5 (Q), U21.11 (C)
unnamed: U21.8 (~Q), U21.12 (D)
O1: C44.2; also elsewhere on the board
OPTION: R136.1; also elsewhere on the board
OSC: L37.2; also elsewhere on the board
RD5: U17.11 (T3); also elsewhere on the board
RW: U17.33 (R/~W); also elsewhere on the board
SELECT: R135.1; also elsewhere on the board
START: R134.1; also elsewhere on the board
TRIG0: L30.1; also elsewhere on the board
TRIG1: L23.1; also elsewhere on the board

Notes on the sheet:
When L=470R C206 is not mounted

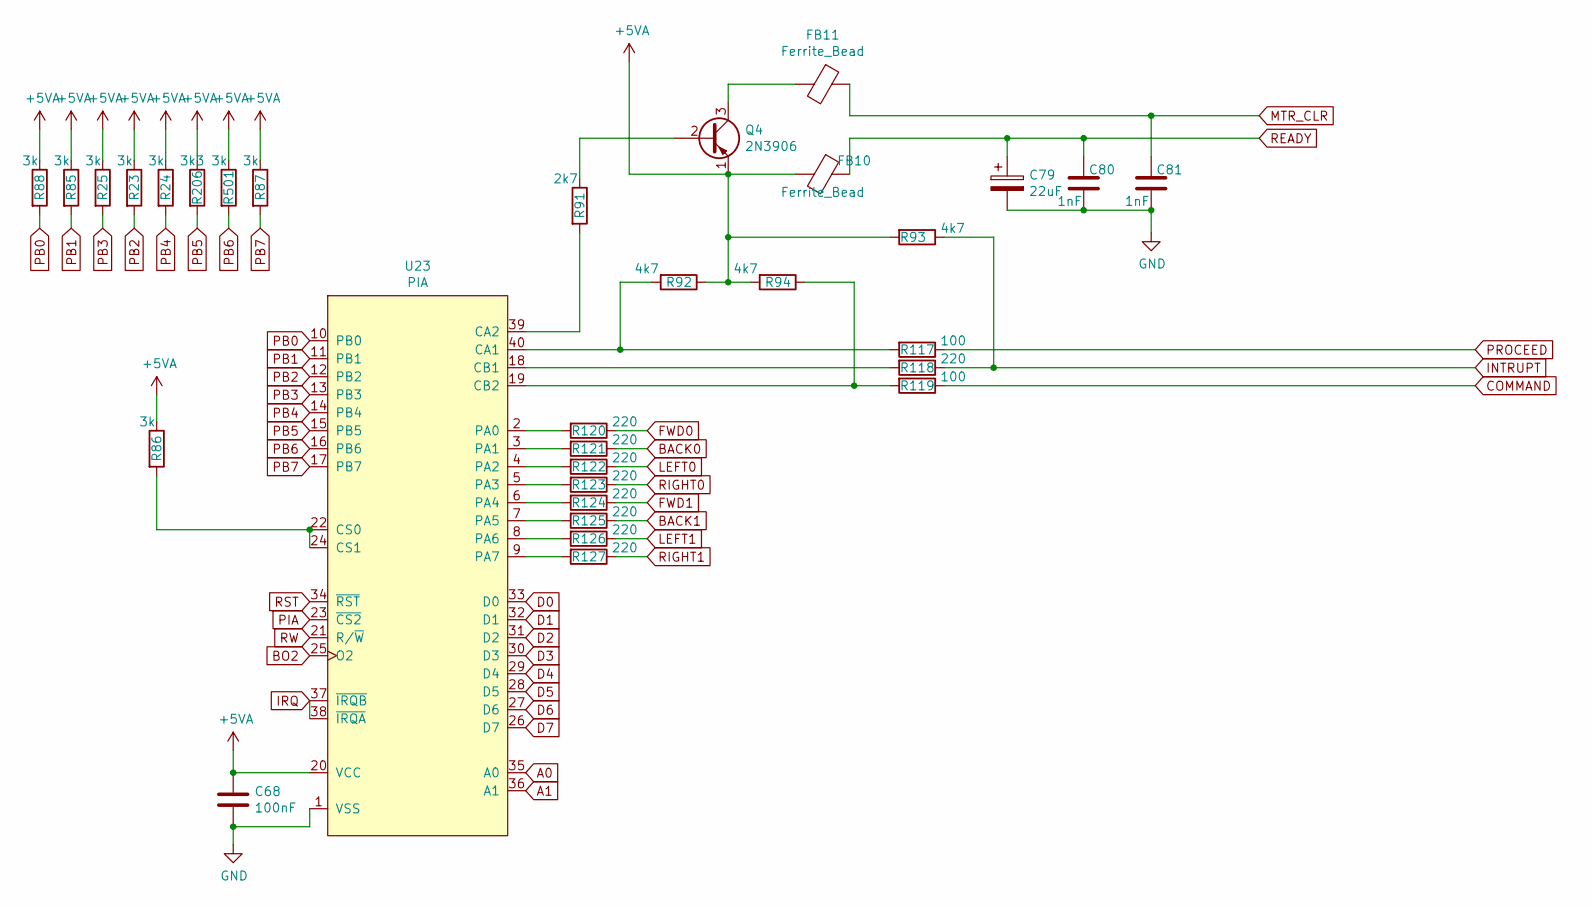
[picture p11: schematic PIA.sch]

Parts:
C68: 100nF; C_Axial_L5.1mm_D2.5mm_P12.50mm_Horizontal
C79: 22uF; CP_Radial_D7.5mm_P2.50mm
C80, C81: 1nF; C_Axial_L5.1mm_D2.5mm_P12.50mm_Horizontal
FB10, FB11: Ferrite_Bead; L_Axial_L7.0mm_D3.3mm_P12.50mm_Horizontal_Fastron_MICC
Q4: 2N3906; TO-92_Wide
R23, R24, R25, R85, R87, R88, R501: 3k; R_1206_3216Metric_Pad1.42x1.75mm_HandSolder
R86: 3k; R_Axial_DIN0207_L3.6mm_D2.2mm_P10.16mm_Horizontal
R91: 2k7; R_Axial_DIN0207_L3.6mm_D2.2mm_P10.16mm_Horizontal
R92, R93, R94: 4k7; R_Axial_DIN0207_L3.6mm_D2.2mm_P10.16mm_Horizontal
R117, R119: 100; R_Axial_DIN0207_L3.6mm_D2.2mm_P10.16mm_Horizontal
R118, R120, R121, R122, R123, R124, R125, R126, R127: 220; R_Axial_DIN0207_L3.6mm_D2.2mm_P10.16mm_Horizontal
R206: 3k3; R_1206_3216Metric_Pad1.42x1.75mm_HandSolder
U23: PIA; DIP-40_W15.24mm_Socket

Connections:
+5VA: C68.1, FB10.2, Q4.1 (E), R23.1, R24.1, R25.1, R85.1, R86.1, R87.1, R88.1, R92.1, R93.2, R94.2, R206.1, R501.1, U23.20 (VCC); also elsewhere on the board
A0: U23.35 (A0); also elsewhere on the board
A1: U23.36 (A1); also elsewhere on the board
BACK0: R121.1; also elsewhere on the board
BACK1: R125.1; also elsewhere on the board
BO2: U23.25 (O2); also elsewhere on the board
COMMAND: R119.1; also elsewhere on the board
D0: U23.33 (D0); also elsewhere on the board
D1: U23.32 (D1); also elsewhere on the board
D2: U23.31 (D2); also elsewhere on the board
D3: U23.30 (D3); also elsewhere on the board
D4: U23.29 (D4); also elsewhere on the board
D5: U23.28 (D5); also elsewhere on the board
D6: U23.27 (D6); also elsewhere on the board
D7: U23.26 (D7); also elsewhere on the board
FWD0: R120.1; also elsewhere on the board
FWD1: R124.1; also elsewhere on the board
GND: C68.2, C79.2, C80.2, C81.2, U23.1 (VSS); also elsewhere on the board
INTRUPT: R93.1, R118.1; also elsewhere on the board
IRQ: U23.37 (~IRQB), U23.38 (~IRQA); also elsewhere on the board
LEFT0: R122.1; also elsewhere on the board
LEFT1: R126.1; also elsewhere on the board
MTR_CLR: C81.1, FB11.1; also elsewhere on the board
unnamed: FB11.2, Q4.3 (C)
unnamed: Q4.2 (B), R91.1
unnamed: R86.2, U23.22 (CS0), U23.24 (CS1)
unnamed: R91.2, U23.39 (CA2)
unnamed: R92.2, R117.2, U23.40 (CA1)
unnamed: R118.2, U23.18 (CB1)
unnamed: R94.1, R119.2, U23.19 (CB2)
unnamed: R120.2, U23.2 (PA0)
unnamed: R121.2, U23.3 (PA1)
unnamed: R122.2, U23.4 (PA2)
unnamed: R123.2, U23.5 (PA3)
unnamed: R124.2, U23.6 (PA4)
unnamed: R125.2, U23.7 (PA5)
unnamed: R126.2, U23.8 (PA6)
unnamed: R127.2, U23.9 (PA7)
PB0: R88.2, U23.10 (PB0); also elsewhere on the board
PB1: R85.2, U23.11 (PB1); also elsewhere on the board
PB2: R23.2, U23.12 (PB2); also elsewhere on the board
PB3: R25.2, U23.13 (PB3); also elsewhere on the board
PB4: R24.2, U23.14 (PB4); also elsewhere on the board
PB5: R206.2, U23.15 (PB5); also elsewhere on the board
PB6: R501.2, U23.16 (PB6); also elsewhere on the board
PB7: R87.2, U23.17 (PB7); also elsewhere on the board
PIA: U23.23 (~CS2); also elsewhere on the board
PROCEED: R117.1; also elsewhere on the board
READY: C79.1, C80.1, FB10.1; also elsewhere on the board
RIGHT0: R123.1; also elsewhere on the board
RIGHT1: R127.1; also elsewhere on the board
RST: U23.34 (~RST); also elsewhere on the board
RW: U23.21 (R/~W); also elsewhere on the board

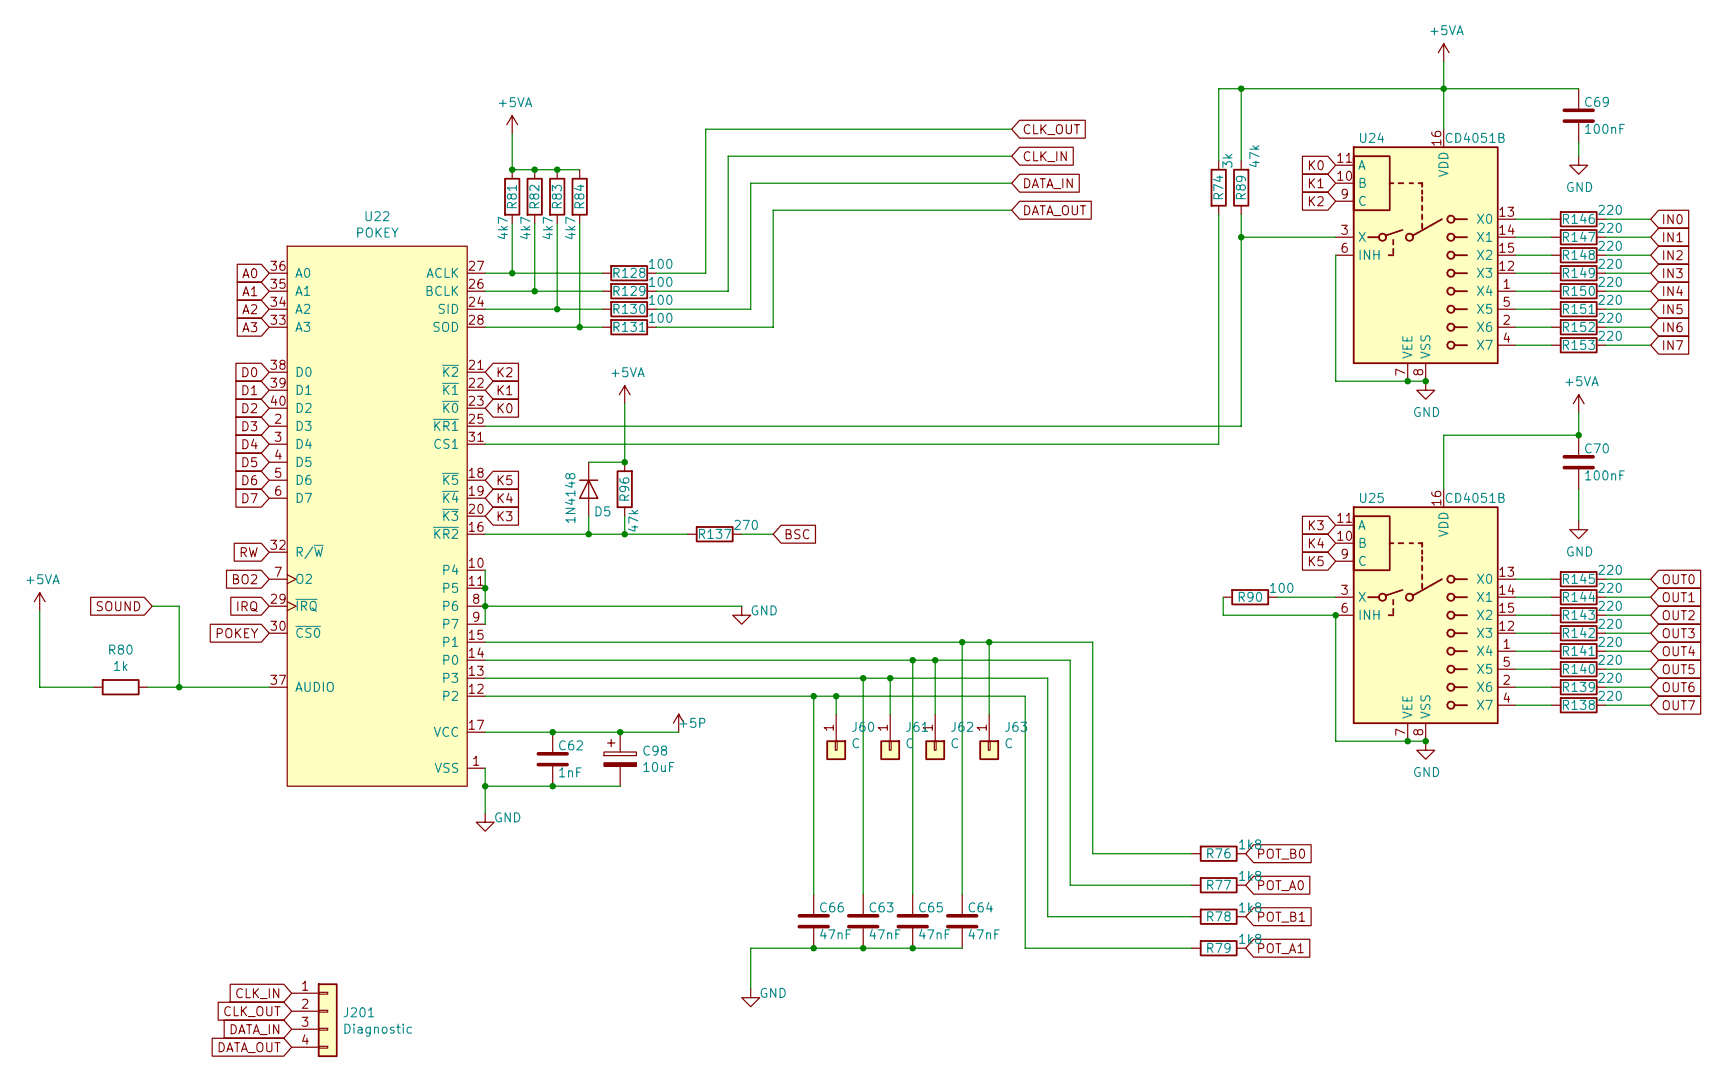
[picture p12: schematic POKEY.sch]

Parts:
C62: 1nF; C_Axial_L5.1mm_D2.5mm_P12.50mm_Horizontal
C63, C64, C65, C66: 47nF; C_Axial_L5.1mm_D2.5mm_P12.50mm_Horizontal
C69, C70: 100nF; C_1206_3216Metric_Pad1.42x1.75mm_HandSolder
C98: 10uF; CP_Radial_D5.0mm_P2.00mm
D5: 1N4148; D_1206_3216Metric_Pad1.42x1.75mm_HandSolder
J60, J61, J62, J63: C; PinHeader_1x01_P2.54mm_Vertical
J201: Diagnostic; PinHeader_1x04_P2.54mm_Vertical
R74: 3k; R_Axial_DIN0207_L3.6mm_D2.2mm_P10.16mm_Horizontal
R76, R77, R78, R79: 1k8; R_Axial_DIN0207_L3.6mm_D2.2mm_P10.16mm_Horizontal
R80: 1k; R_1206_3216Metric_Pad1.42x1.75mm_HandSolder
R81, R82, R83, R84: 4k7; R_Axial_DIN0207_L3.6mm_D2.2mm_P10.16mm_Horizontal
R89, R96: 47k; R_1206_3216Metric_Pad1.42x1.75mm_HandSolder
R90: 100; R_1206_3216Metric_Pad1.42x1.75mm_HandSolder
R128, R129, R130, R131: 100; R_Axial_DIN0207_L3.6mm_D2.2mm_P10.16mm_Horizontal
R137: 270; R_1206_3216Metric_Pad1.42x1.75mm_HandSolder
R138, R139, R140, R141, R142, R143, R144, R145, R146, R147, R148, R149, R150, R151, R152, R153: 220; R_1206_3216Metric_Pad1.42x1.75mm_HandSolder
U22: POKEY; DIP-40_W15.24mm_Socket
U24, U25: CD4051B; DIP-16_W7.62mm_Socket

Connections:
+5P: C62.1, C98.1, U22.17 (VCC); also elsewhere on the board
+5VA: C69.1, C70.1, D5.1 (K), R74.1, R80.2, R81.1, R82.1, R83.1, R84.1, R89.2, R96.2, U24.16 (VDD), U25.16 (VDD); also elsewhere on the board
A0: U22.36 (A0); also elsewhere on the board
A1: U22.35 (A1); also elsewhere on the board
A2: U22.34 (A2); also elsewhere on the board
A3: U22.33 (A3); also elsewhere on the board
BO2: U22.7 (O2); also elsewhere on the board
BSC: R137.1; also elsewhere on the board
CLK_IN: J201.1, R129.1; also elsewhere on the board
CLK_OUT: J201.2, R128.1; also elsewhere on the board
D0: U22.38 (D0); also elsewhere on the board
D1: U22.39 (D1); also elsewhere on the board
D2: U22.40 (D2); also elsewhere on the board
D3: U22.2 (D3); also elsewhere on the board
D4: U22.3 (D4); also elsewhere on the board
D5: U22.4 (D5); also elsewhere on the board
D6: U22.5 (D6); also elsewhere on the board
D7: U22.6 (D7); also elsewhere on the board
DATA_IN: J201.3, R130.1; also elsewhere on the board
DATA_OUT: J201.4, R131.1; also elsewhere on the board
GND: C62.2, C63.2, C64.2, C65.2, C66.2, C69.2, C70.2, C98.2, R90.2, U22.1 (VSS), U22.8 (P6), U22.9 (P7), U22.10 (P4), U22.11 (P5), U24.6 (INH), U24.7 (VEE), U24.8 (VSS), U25.6 (INH), U25.7 (VEE), U25.8 (VSS); also elsewhere on the board
IN0: R146.1; also elsewhere on the board
IN1: R147.1; also elsewhere on the board
IN2: R148.1; also elsewhere on the board
IN3: R149.1; also elsewhere on the board
IN4: R150.1; also elsewhere on the board
IN5: R151.1; also elsewhere on the board
IN6: R152.1; also elsewhere on the board
IN7: R153.1; also elsewhere on the board
IRQ: U22.29 (~IRQ); also elsewhere on the board
K0: U22.23 (~K0), U24.11 (A)
K1: U22.22 (~K1), U24.10 (B)
K2: U22.21 (~K2), U24.9 (C)
K3: U22.20 (~K3), U25.11 (A)
K4: U22.19 (~K4), U25.10 (B)
K5: U22.18 (~K5), U25.9 (C)
unnamed: C63.1, J61.1, R78.2, U22.13 (P3)
unnamed: C64.1, J63.1, R76.2, U22.15 (P1)
unnamed: C65.1, J62.1, R77.2, U22.14 (P0)
unnamed: C66.1, J60.1, R79.2, U22.12 (P2)
unnamed: D5.2 (A), R96.1, R137.2, U22.16 (~KR2)
unnamed: R74.2, U22.31 (CS1)
unnamed: R89.1, U22.25 (~KR1), U24.3 (X)
unnamed: R90.1, U25.3 (X)
unnamed: R81.2, R128.2, U22.27 (ACLK)
unnamed: R82.2, R129.2, U22.26 (BCLK)
unnamed: R83.2, R130.2, U22.24 (SID)
unnamed: R84.2, R131.2, U22.28 (SOD)
unnamed: R138.2, U25.4 (X7)
unnamed: R139.2, U25.2 (X6)
unnamed: R140.2, U25.5 (X5)
unnamed: R141.2, U25.1 (X4)
unnamed: R142.2, U25.12 (X3)
unnamed: R143.2, U25.15 (X2)
unnamed: R144.2, U25.14 (X1)
unnamed: R145.2, U25.13 (X0)
unnamed: R146.2, U24.13 (X0)
unnamed: R147.2, U24.14 (X1)
unnamed: R148.2, U24.15 (X2)
unnamed: R149.2, U24.12 (X3)
unnamed: R150.2, U24.1 (X4)
unnamed: R151.2, U24.5 (X5)
unnamed: R152.2, U24.2 (X6)
unnamed: R153.2, U24.4 (X7)
OUT0: R145.1; also elsewhere on the board
OUT1: R144.1; also elsewhere on the board
OUT2: R143.1; also elsewhere on the board
OUT3: R142.1; also elsewhere on the board
OUT4: R141.1; also elsewhere on the board
OUT5: R140.1; also elsewhere on the board
OUT6: R139.1; also elsewhere on the board
OUT7: R138.1; also elsewhere on the board
POKEY: U22.30 (~CS0); also elsewhere on the board
POT_A0: R77.1; also elsewhere on the board
POT_A1: R79.1; also elsewhere on the board
POT_B0: R76.1; also elsewhere on the board
POT_B1: R78.1; also elsewhere on the board
RW: U22.32 (R/~W); also elsewhere on the board
SOUND: R80.1, U22.37 (AUDIO); also elsewhere on the board

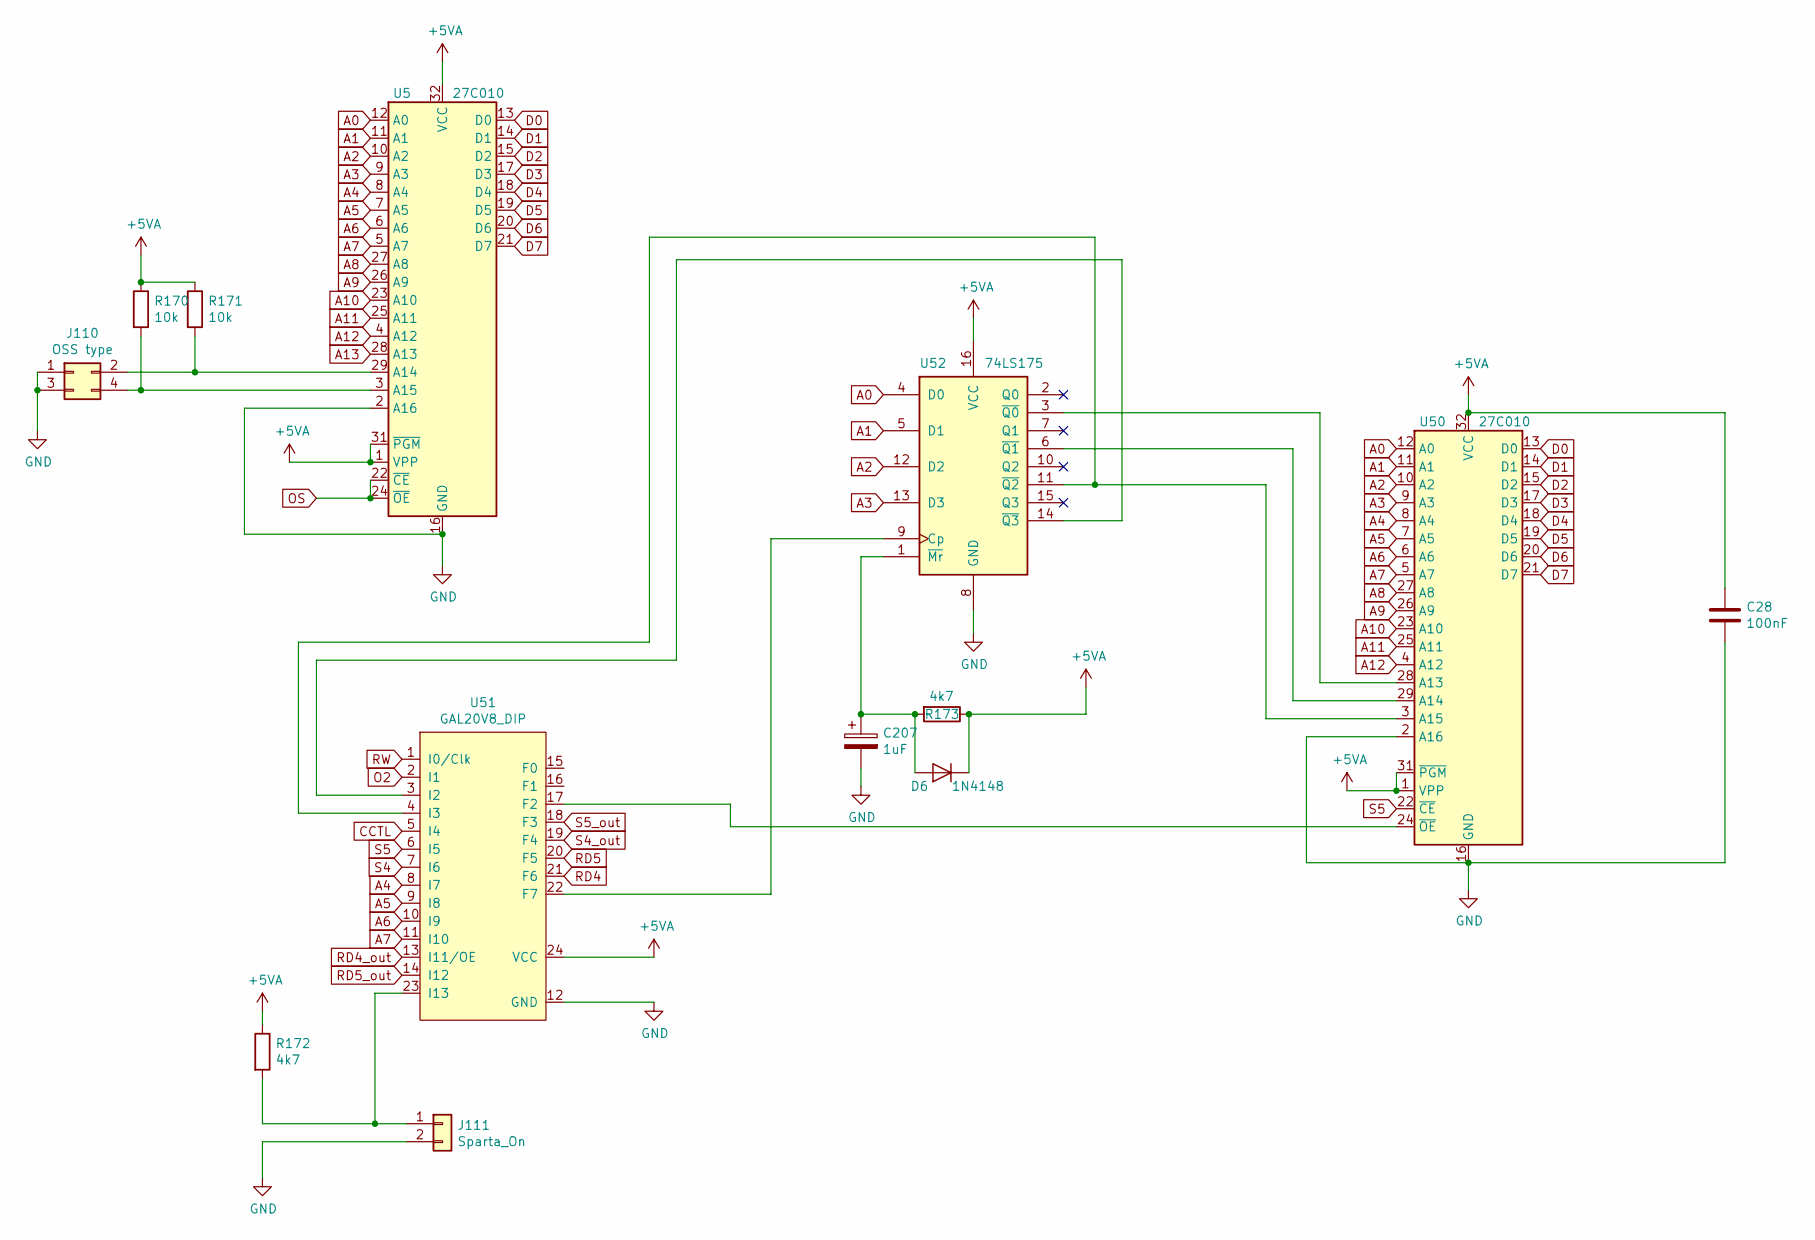
[picture p13: schematic OSS.sch]

Parts:
C28: 100nF; C_1206_3216Metric_Pad1.42x1.75mm_HandSolder
C207: 1uF; CP_EIA-3528-21_Kemet-B_Pad1.50x2.35mm_HandSolder
D6: 1N4148; D_1206_3216Metric_Pad1.42x1.75mm_HandSolder
J110: OSS type; PinHeader_2x02_P2.54mm_Vertical
J111: Sparta_On; PinHeader_1x02_P2.54mm_Vertical
R170, R171: 10k; R_1206_3216Metric_Pad1.42x1.75mm_HandSolder
R172, R173: 4k7; R_1206_3216Metric_Pad1.42x1.75mm_HandSolder
U5, U50: 27C010; PLCC-32_THT-Socket
U51: GAL20V8_DIP; DIP-24_W7.62mm_Socket
U52: 74LS175; SOP-16_4.4x10.4mm_P1.27mm

Connections:
+5VA: C28.1, D6.1 (K), R170.1, R171.1, R172.1, R173.1, U5.1 (VPP), U5.31 (~PGM), U5.32 (VCC), U50.1 (VPP), U50.31 (~PGM), U50.32 (VCC), U51.24 (VCC), U52.16 (VCC); also elsewhere on the board
A0: U5.12 (A0), U50.12 (A0), U52.4 (D0); also elsewhere on the board
A1: U5.11 (A1), U50.11 (A1), U52.5 (D1); also elsewhere on the board
A2: U5.10 (A2), U50.10 (A2), U52.12 (D2); also elsewhere on the board
A3: U5.9 (A3), U50.9 (A3), U52.13 (D3); also elsewhere on the board
A4: U5.8 (A4), U50.8 (A4), U51.8 (I7); also elsewhere on the board
A5: U5.7 (A5), U50.7 (A5), U51.9 (I8); also elsewhere on the board
A6: U5.6 (A6), U50.6 (A6), U51.10 (I9); also elsewhere on the board
A7: U5.5 (A7), U50.5 (A7), U51.11 (I10); also elsewhere on the board
A8: U5.27 (A8), U50.27 (A8); also elsewhere on the board
A9: U5.26 (A9), U50.26 (A9); also elsewhere on the board
A10: U5.23 (A10), U50.23 (A10); also elsewhere on the board
A11: U5.25 (A11), U50.25 (A11); also elsewhere on the board
A12: U5.4 (A12), U50.4 (A12); also elsewhere on the board
A13: U5.28 (A13); also elsewhere on the board
CCTL: U51.5 (I4); also elsewhere on the board
D0: U5.13 (D0), U50.13 (D0); also elsewhere on the board
D1: U5.14 (D1), U50.14 (D1); also elsewhere on the board
D2: U5.15 (D2), U50.15 (D2); also elsewhere on the board
D3: U5.17 (D3), U50.17 (D3); also elsewhere on the board
D4: U5.18 (D4), U50.18 (D4); also elsewhere on the board
D5: U5.19 (D5), U50.19 (D5); also elsewhere on the board
D6: U5.20 (D6), U50.20 (D6); also elsewhere on the board
D7: U5.21 (D7), U50.21 (D7); also elsewhere on the board
GND: C28.2, C207.2, J110.1, J110.3, J111.2, U5.2 (A16), U5.16 (GND), U50.2 (A16), U50.16 (GND), U51.12 (GND), U52.8 (GND); also elsewhere on the board
unnamed: C207.1, D6.2 (A), R173.2, U52.1 (~Mr)
unnamed: J110.2, R171.2, U5.29 (A14)
unnamed: J110.4, R170.2, U5.3 (A15)
unnamed: J111.1, R172.2, U51.23 (I13)
unnamed: U50.3 (A15), U51.4 (I3), U52.11 (~Q2)
unnamed: U50.24 (~OE), U51.17 (F2)
unnamed: U50.28 (A13), U52.3 (~Q0)
unnamed: U50.29 (A14), U52.6 (~Q1)
unnamed: U51.3 (I2), U52.14 (~Q3)
unnamed: U51.22 (F7), U52.9 (Cp)
O2: U51.2 (I1); also elsewhere on the board
OS: U5.22 (~CE), U5.24 (~OE); also elsewhere on the board
RD4: U51.21 (F6); also elsewhere on the board
RD4_out: U51.13 (I11/OE); also elsewhere on the board
RD5: U51.20 (F5); also elsewhere on the board
RD5_out: U51.14 (I12); also elsewhere on the board
RW: U51.1 (I0/Clk); also elsewhere on the board
S4: U51.7 (I6); also elsewhere on the board
S4_out: U51.19 (F4); also elsewhere on the board
S5: U50.22 (~CE), U51.6 (I5); also elsewhere on the board
S5_out: U51.18 (F3); also elsewhere on the board

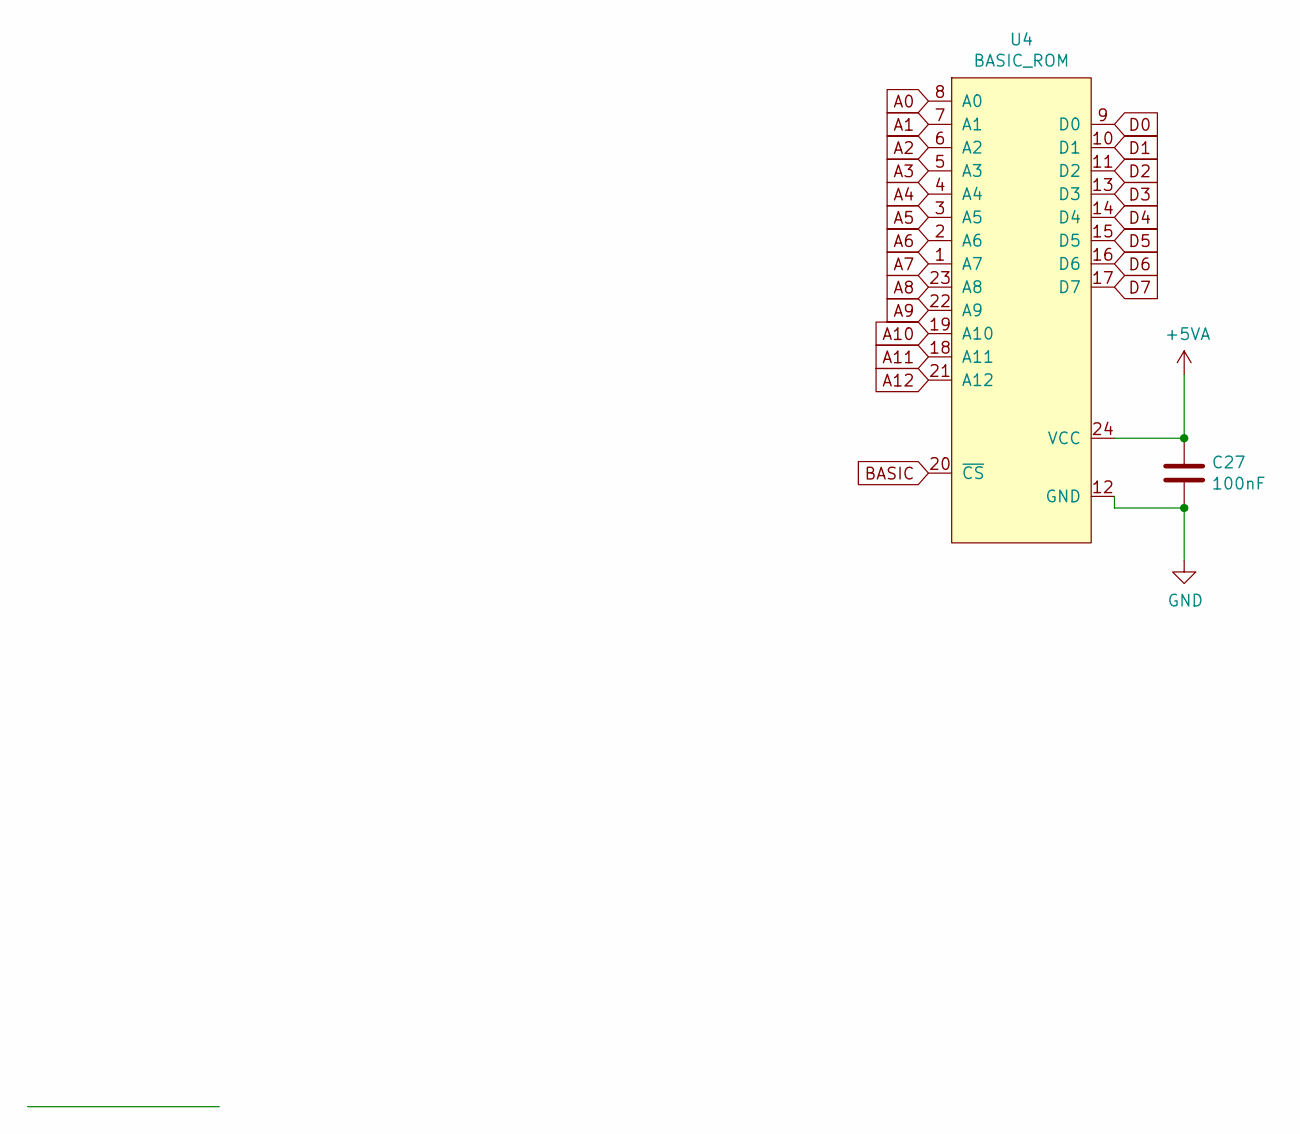
[picture p14: schematic BASIC.sch]

Parts:
C27: 100nF; C_1206_3216Metric_Pad1.42x1.75mm_HandSolder
U4: BASIC_ROM; DIP-24_W15.24mm_Socket

Connections:
+5VA: C27.1, U4.24 (VCC); also elsewhere on the board
A0: U4.8 (A0); also elsewhere on the board
A1: U4.7 (A1); also elsewhere on the board
A2: U4.6 (A2); also elsewhere on the board
A3: U4.5 (A3); also elsewhere on the board
A4: U4.4 (A4); also elsewhere on the board
A5: U4.3 (A5); also elsewhere on the board
A6: U4.2 (A6); also elsewhere on the board
A7: U4.1 (A7); also elsewhere on the board
A8: U4.23 (A8); also elsewhere on the board
A9: U4.22 (A9); also elsewhere on the board
A10: U4.19 (A10); also elsewhere on the board
A11: U4.18 (A11); also elsewhere on the board
A12: U4.21 (A12); also elsewhere on the board
BASIC: U4.20 (~CS); also elsewhere on the board
D0: U4.9 (D0); also elsewhere on the board
D1: U4.10 (D1); also elsewhere on the board
D2: U4.11 (D2); also elsewhere on the board
D3: U4.13 (D3); also elsewhere on the board
D4: U4.14 (D4); also elsewhere on the board
D5: U4.15 (D5); also elsewhere on the board
D6: U4.16 (D6); also elsewhere on the board
D7: U4.17 (D7); also elsewhere on the board
GND: C27.2, U4.12 (GND); also elsewhere on the board
