binkul/Atari_130XE_1MB_SpartaDosX_SIO2SD/Atari 130XE 1MB Sparta.kicad_pcb

## KiCad design Atari 130XE 1MB Sparta.kicad_pcb (continued)

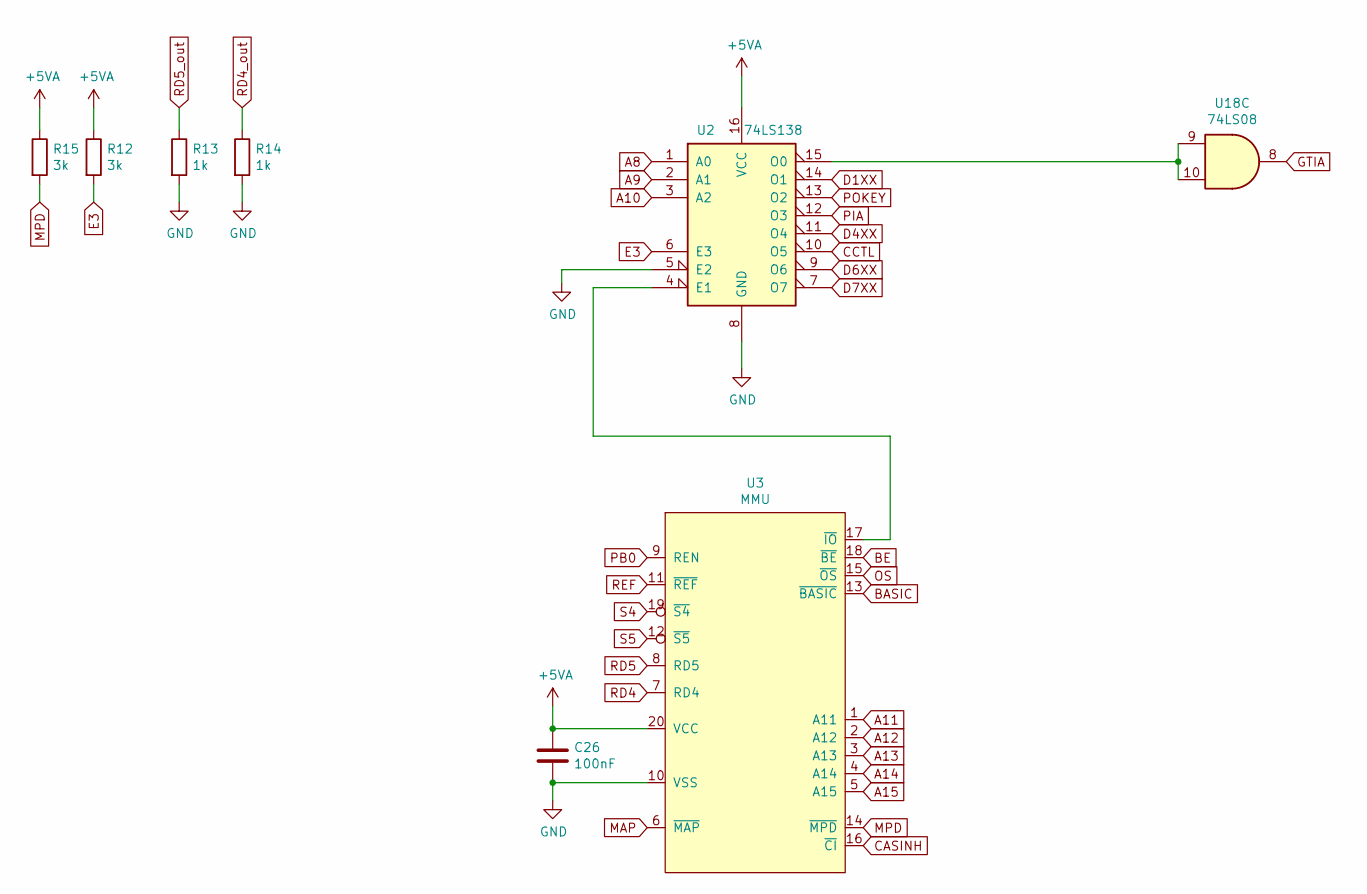
[picture p15: schematic MMU.sch]

Parts:
C26: 100nF; C_Axial_L5.1mm_D2.5mm_P12.50mm_Horizontal
R12, R15: 3k; R_Axial_DIN0207_L3.6mm_D2.2mm_P10.16mm_Horizontal
R13, R14: 1k; R_Axial_DIN0207_L3.6mm_D2.2mm_P10.16mm_Horizontal
U2: 74LS138; DIP-16_W7.62mm_Socket
U3: MMU; DIP-20_W7.62mm_Socket
U18: 74LS08; DIP-14_W7.62mm_Socket

Connections:
+5VA: C26.1, R12.1, R15.1, U2.16 (VCC), U3.20 (VCC); also elsewhere on the board
A8: U2.1 (A0); also elsewhere on the board
A9: U2.2 (A1); also elsewhere on the board
A10: U2.3 (A2); also elsewhere on the board
A11: U3.1 (A11); also elsewhere on the board
A12: U3.2 (A12); also elsewhere on the board
A13: U3.3 (A13); also elsewhere on the board
A14: U3.4 (A14); also elsewhere on the board
A15: U3.5 (A15); also elsewhere on the board
BASIC: U3.13 (~BASIC); also elsewhere on the board
BE: U3.18 (~BE); also elsewhere on the board
CASINH: U3.16 (~CI); also elsewhere on the board
CCTL: U2.10 (O5); also elsewhere on the board
D1XX: U2.14 (O1); also elsewhere on the board
E3: R12.2, U2.6 (E3)
GND: C26.2, R13.2, R14.2, U2.5 (E2), U2.8 (GND), U3.10 (VSS); also elsewhere on the board
GTIA: U18.8; also elsewhere on the board
MAP: U3.6 (~MAP); also elsewhere on the board
MPD: R15.2, U3.14 (~MPD); also elsewhere on the board
unnamed: U2.4 (E1), U3.17 (~IO)
unnamed: U2.15 (O0), U18.9, U18.10
OS: U3.15 (~OS); also elsewhere on the board
PB0: U3.9 (REN); also elsewhere on the board
PIA: U2.12 (O3); also elsewhere on the board
POKEY: U2.13 (O2); also elsewhere on the board
RD4: U3.7 (RD4); also elsewhere on the board
RD4_out: R14.1; also elsewhere on the board
RD5: U3.8 (RD5); also elsewhere on the board
RD5_out: R13.1; also elsewhere on the board
REF: U3.11 (~REF); also elsewhere on the board
S4: U3.19 (~S4); also elsewhere on the board
S5: U3.12 (~S5); also elsewhere on the board

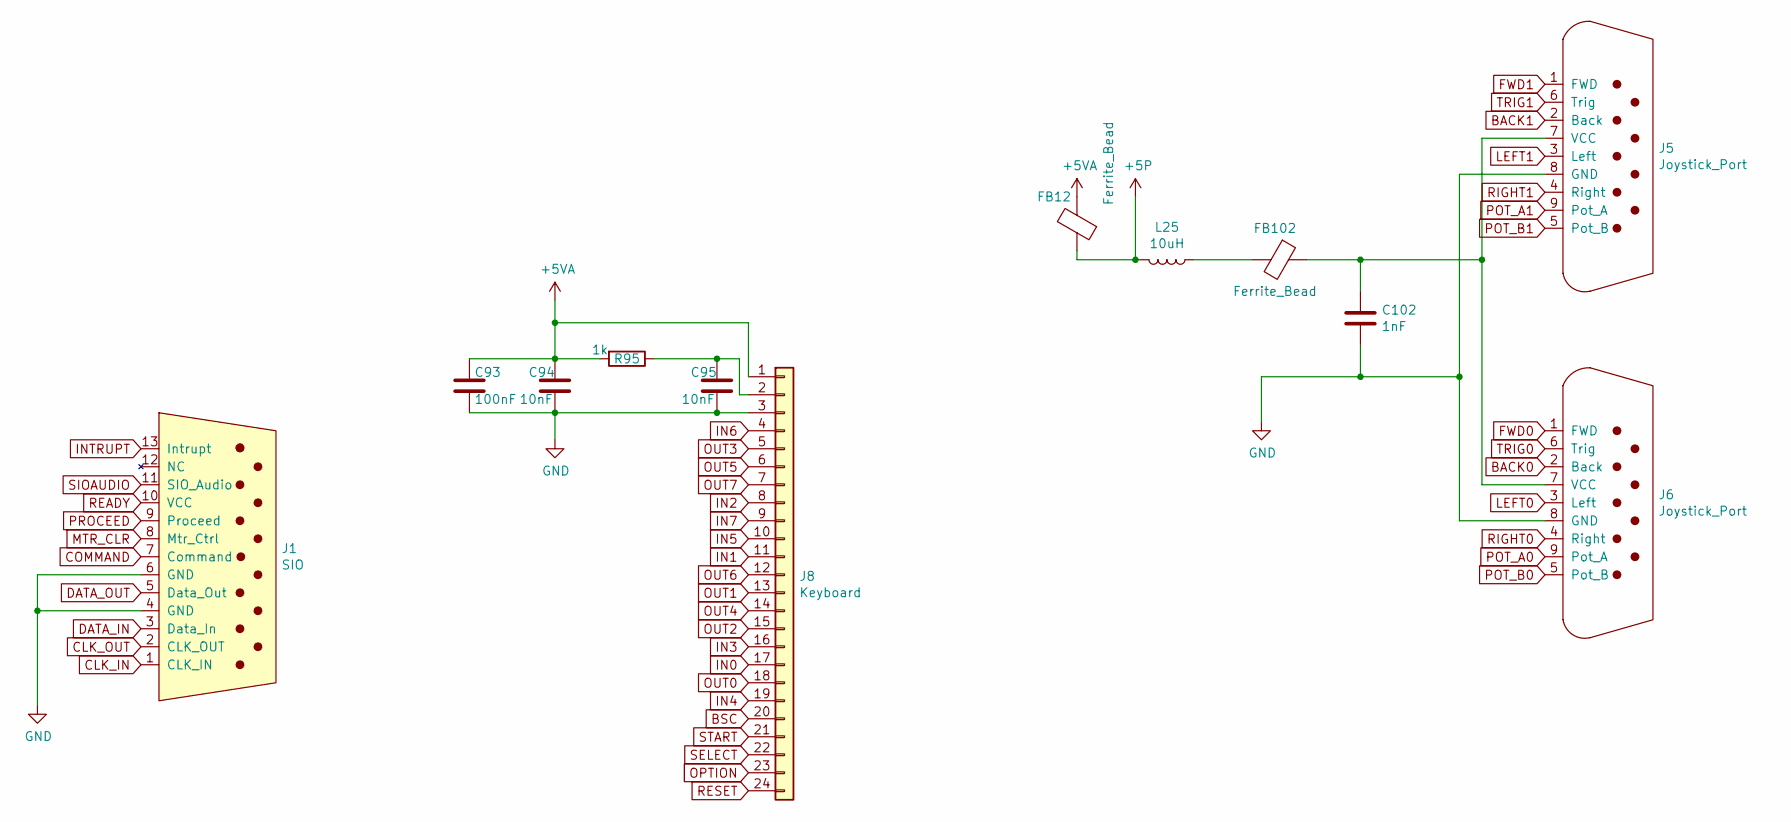
[picture p16: schematic Ports.sch]

Parts:
C93: 100nF; C_1206_3216Metric_Pad1.42x1.75mm_HandSolder
C94, C95: 10nF; C_1206_3216Metric_Pad1.42x1.75mm_HandSolder
C102: 1nF; C_Axial_L5.1mm_D2.5mm_P12.50mm_Horizontal
FB12, FB102: Ferrite_Bead; L_Axial_L7.0mm_D3.3mm_P12.50mm_Horizontal_Fastron_MICC
J1: SIO; SIO_Slot
J5, J6: Joystick_Port; Joystick_Pport
J8: Keyboard; PinHeader_1x24_P2.54mm_Vertical
L25: 10uH; L_Axial_L7.0mm_D3.3mm_P12.50mm_Horizontal_Fastron_MICC
R95: 1k; R_1206_3216Metric_Pad1.42x1.75mm_HandSolder

Connections:
+5P: FB12.1, L25.2; also elsewhere on the board
+5VA: C93.1, C94.1, FB12.2, J8.1, R95.2; also elsewhere on the board
BACK0: J6.2 (Back); also elsewhere on the board
BACK1: J5.2 (Back); also elsewhere on the board
BSC: J8.20; also elsewhere on the board
CLK_IN: J1.1 (CLK_IN); also elsewhere on the board
CLK_OUT: J1.2 (CLK_OUT); also elsewhere on the board
COMMAND: J1.7 (Command); also elsewhere on the board
DATA_IN: J1.3 (Data_In); also elsewhere on the board
DATA_OUT: J1.5 (Data_Out); also elsewhere on the board
FWD0: J6.1 (FWD); also elsewhere on the board
FWD1: J5.1 (FWD); also elsewhere on the board
GND: C93.2, C94.2, C95.2, C102.2, J1.4 (GND), J1.6 (GND), J5.8 (GND), J6.8 (GND), J8.3; also elsewhere on the board
IN0: J8.17; also elsewhere on the board
IN1: J8.11; also elsewhere on the board
IN2: J8.8; also elsewhere on the board
IN3: J8.16; also elsewhere on the board
IN4: J8.19; also elsewhere on the board
IN5: J8.10; also elsewhere on the board
IN6: J8.4; also elsewhere on the board
IN7: J8.9; also elsewhere on the board
INTRUPT: J1.13 (Intrupt); also elsewhere on the board
LEFT0: J6.3 (Left); also elsewhere on the board
LEFT1: J5.3 (Left); also elsewhere on the board
MTR_CLR: J1.8 (Mtr_Ctrl); also elsewhere on the board
unnamed: C95.1, J8.2, R95.1
unnamed: C102.1, FB102.1, J5.7 (VCC), J6.7 (VCC)
unnamed: FB102.2, L25.1
OPTION: J8.23; also elsewhere on the board
OUT0: J8.18; also elsewhere on the board
OUT1: J8.13; also elsewhere on the board
OUT2: J8.15; also elsewhere on the board
OUT3: J8.5; also elsewhere on the board
OUT4: J8.14; also elsewhere on the board
OUT5: J8.6; also elsewhere on the board
OUT6: J8.12; also elsewhere on the board
OUT7: J8.7; also elsewhere on the board
POT_A0: J6.9 (Pot_A); also elsewhere on the board
POT_A1: J5.9 (Pot_A); also elsewhere on the board
POT_B0: J6.5 (Pot_B); also elsewhere on the board
POT_B1: J5.5 (Pot_B); also elsewhere on the board
PROCEED: J1.9 (Proceed); also elsewhere on the board
READY: J1.10 (VCC); also elsewhere on the board
RESET: J8.24; also elsewhere on the board
RIGHT0: J6.4 (Right); also elsewhere on the board
RIGHT1: J5.4 (Right); also elsewhere on the board
SELECT: J8.22; also elsewhere on the board
SIOAUDIO: J1.11 (SIO_Audio); also elsewhere on the board
START: J8.21; also elsewhere on the board
TRIG0: J6.6 (Trig); also elsewhere on the board
TRIG1: J5.6 (Trig); also elsewhere on the board

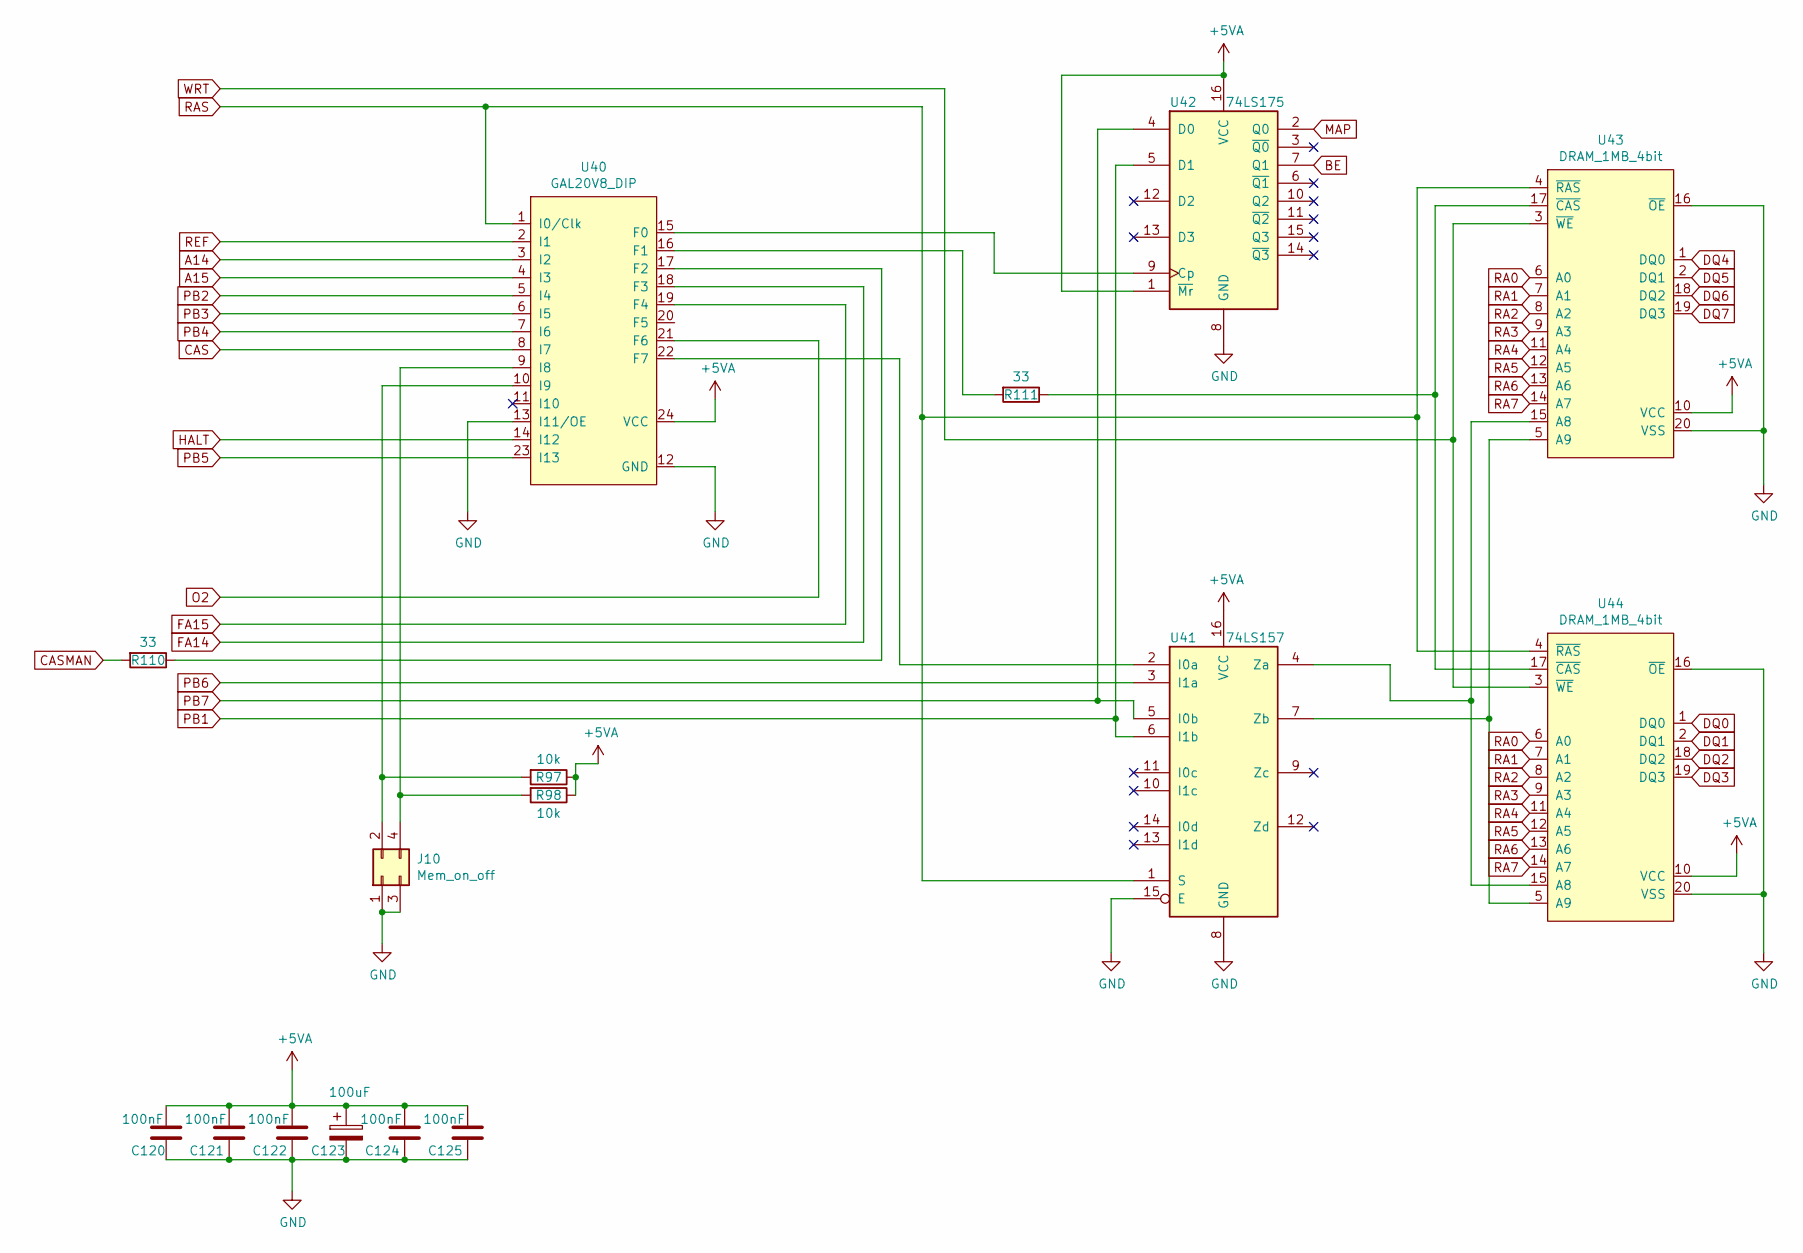
[picture p17: schematic Simm_Expansion.sch]

Parts:
C120, C121, C122, C124, C125: 100nF; C_1206_3216Metric_Pad1.42x1.75mm_HandSolder
C123: 100uF; CP_Elec_6.3x9.9
J10: Mem_on_off; PinHeader_2x02_P2.54mm_Vertical
R97, R98: 10k; R_1206_3216Metric_Pad1.42x1.75mm_HandSolder
R110, R111: 33; R_Axial_DIN0207_L3.6mm_D2.2mm_P10.16mm_Horizontal
U40: GAL20V8_DIP; DIP-24_W7.62mm_Socket
U41: 74LS157; SOP-16_4.4x10.4mm_P1.27mm
U42: 74LS175; SOP-16_4.4x10.4mm_P1.27mm
U43, U44: DRAM_1MB_4bit; SOJ-26

Connections:
+5VA: C120.1, C121.1, C122.1, C123.1, C124.1, C125.1, R97.1, R98.1, U40.24 (VCC), U41.16 (VCC), U42.1 (~Mr), U42.16 (VCC), U43.10 (VCC), U44.10 (VCC); also elsewhere on the board
A14: U40.3 (I2); also elsewhere on the board
A15: U40.4 (I3); also elsewhere on the board
BE: U42.7 (Q1); also elsewhere on the board
CAS: U40.8 (I7); also elsewhere on the board
CASMAN: R110.2; also elsewhere on the board
DQ0: U44.1 (DQ0); also elsewhere on the board
DQ1: U44.2 (DQ1); also elsewhere on the board
DQ2: U44.18 (DQ2); also elsewhere on the board
DQ3: U44.19 (DQ3); also elsewhere on the board
DQ4: U43.1 (DQ0); also elsewhere on the board
DQ5: U43.2 (DQ1); also elsewhere on the board
DQ6: U43.18 (DQ2); also elsewhere on the board
DQ7: U43.19 (DQ3); also elsewhere on the board
FA14: U40.18 (F3); also elsewhere on the board
FA15: U40.19 (F4); also elsewhere on the board
GND: C120.2, C121.2, C122.2, C123.2, C124.2, C125.2, J10.1, J10.3, U40.12 (GND), U40.13 (I11/OE), U41.8 (GND), U41.15 (E), U42.8 (GND), U43.16 (~OE), U43.20 (VSS), U44.16 (~OE), U44.20 (VSS); also elsewhere on the board
HALT: U40.14 (I12); also elsewhere on the board
MAP: U42.2 (Q0); also elsewhere on the board
unnamed: J10.2, R97.2, U40.10 (I9)
unnamed: J10.4, R98.2, U40.9 (I8)
unnamed: R110.1, U40.17 (F2)
unnamed: R111.1, U43.17 (~CAS), U44.17 (~CAS)
unnamed: R111.2, U40.16 (F1)
unnamed: U40.15 (F0), U42.9 (Cp)
unnamed: U40.22 (F7), U41.2 (I0a)
unnamed: U41.4 (Za), U43.15 (A8), U44.15 (A8)
unnamed: U41.7 (Zb), U43.5 (A9), U44.5 (A9)
O2: U40.21 (F6); also elsewhere on the board
PB1: U41.6 (I1b), U42.5 (D1); also elsewhere on the board
PB2: U40.5 (I4); also elsewhere on the board
PB3: U40.6 (I5); also elsewhere on the board
PB4: U40.7 (I6); also elsewhere on the board
PB5: U40.23 (I13); also elsewhere on the board
PB6: U41.3 (I1a); also elsewhere on the board
PB7: U41.5 (I0b), U42.4 (D0); also elsewhere on the board
RA0: U43.6 (A0), U44.6 (A0); also elsewhere on the board
RA1: U43.7 (A1), U44.7 (A1); also elsewhere on the board
RA2: U43.8 (A2), U44.8 (A2); also elsewhere on the board
RA3: U43.9 (A3), U44.9 (A3); also elsewhere on the board
RA4: U43.11 (A4), U44.11 (A4); also elsewhere on the board
RA5: U43.12 (A5), U44.12 (A5); also elsewhere on the board
RA6: U43.13 (A6), U44.13 (A6); also elsewhere on the board
RA7: U43.14 (A7), U44.14 (A7); also elsewhere on the board
RAS: U40.1 (I0/Clk), U41.1 (S), U43.4 (~RAS), U44.4 (~RAS); also elsewhere on the board
REF: U40.2 (I1); also elsewhere on the board
WRT: U43.3 (~WE), U44.3 (~WE); also elsewhere on the board

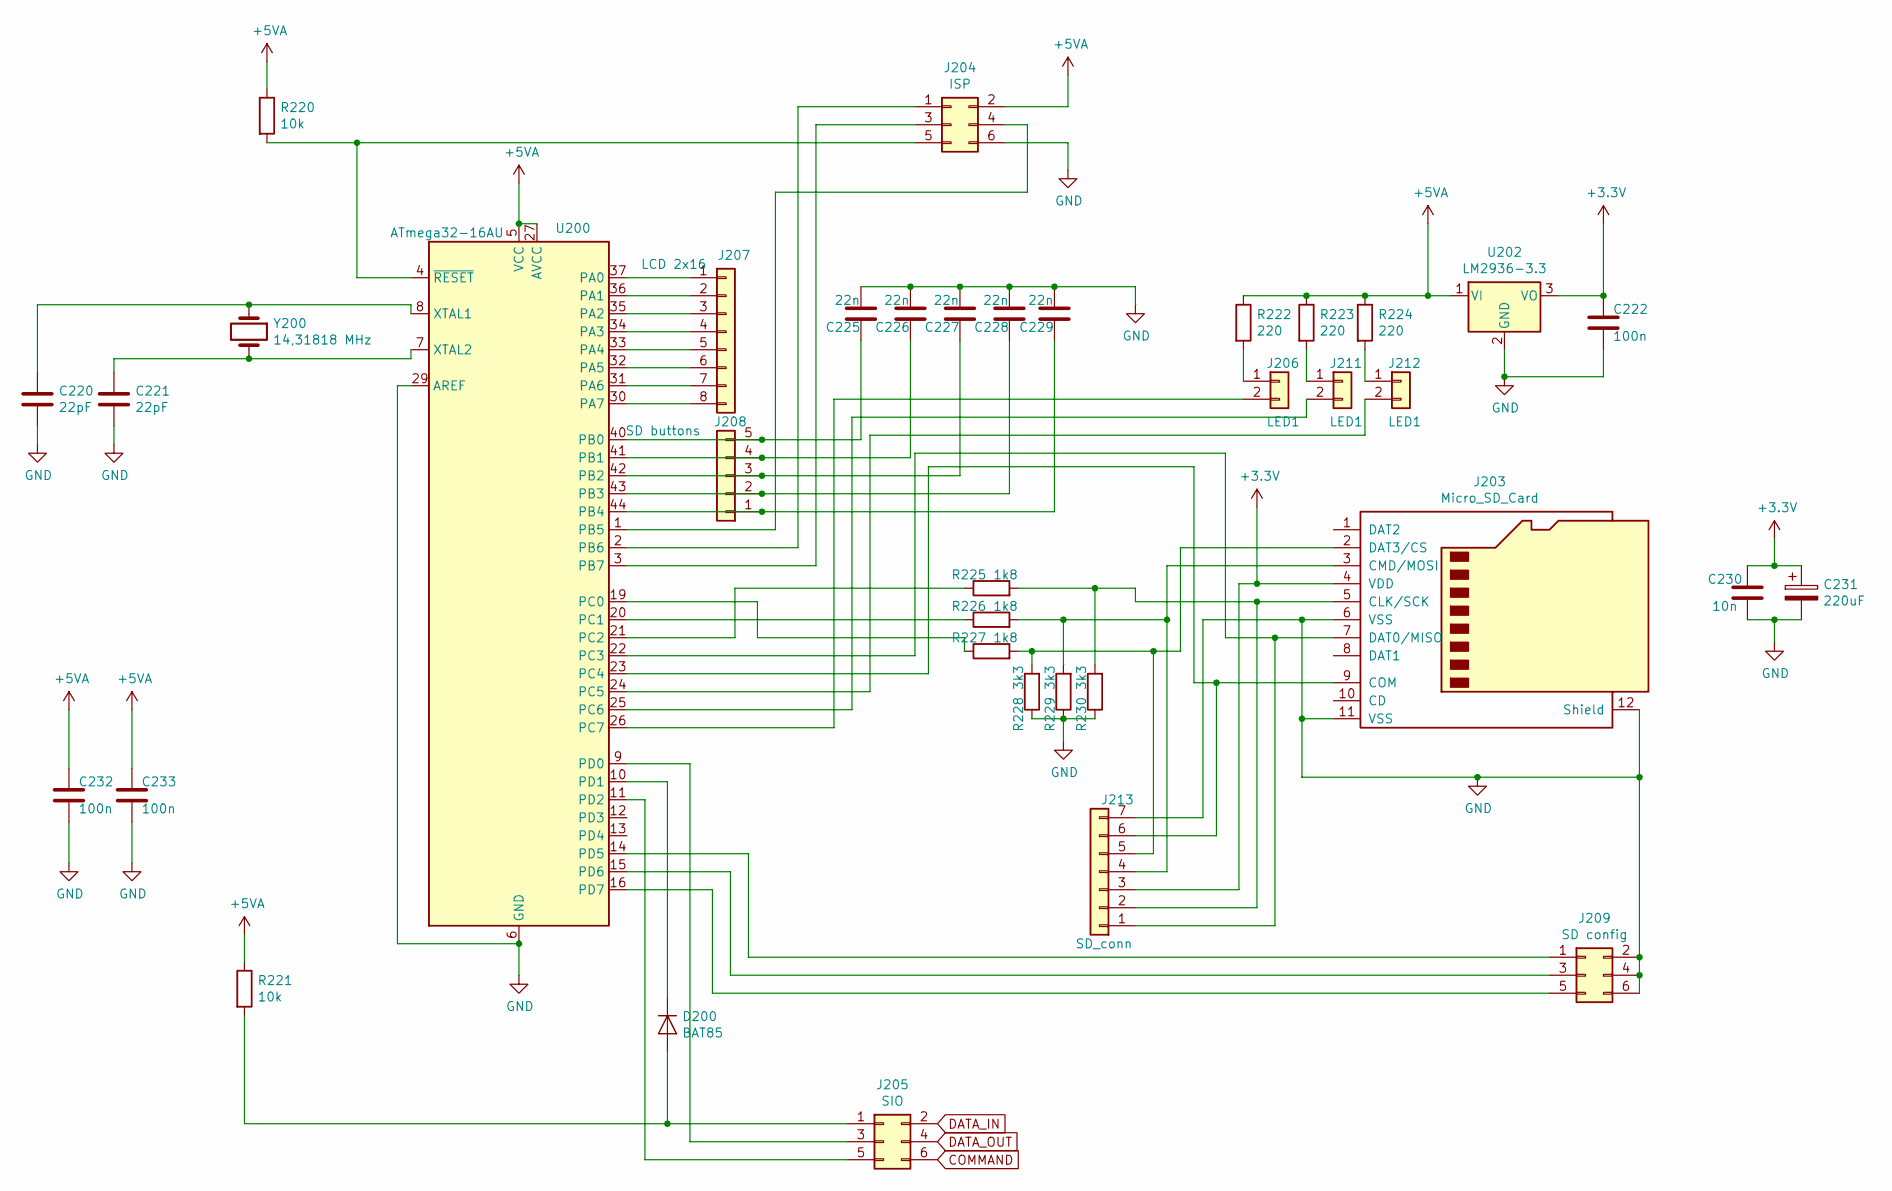
[picture p18: schematic SD_Card.sch]

Parts:
C220, C221: 22pF; C_1206_3216Metric_Pad1.42x1.75mm_HandSolder
C222, C232, C233: 100n; C_1206_3216Metric_Pad1.42x1.75mm_HandSolder
C225, C226, C227, C228, C229: 22n; C_1206_3216Metric_Pad1.42x1.75mm_HandSolder
C230: 10n; C_1206_3216Metric_Pad1.42x1.75mm_HandSolder
C231: 220uF; CP_EIA-7343-40_Kemet-Y_Pad2.25x2.55mm_HandSolder
D200: BAT85; D_MELF
J203: Micro_SD_Card; MCC SDMicro
J204: ISP; IDC-Header_2x03_P2.54mm_Vertical
J205: SIO; PinHeader_2x03_P2.54mm_Vertical
J206, J211, J212: LED1; PinHeader_1x02_P2.54mm_Vertical
J207: LCD 2x16; PinHeader_1x08_P2.54mm_Vertical
J208: SD buttons; PinHeader_1x05_P2.54mm_Vertical
J209: SD config; PinHeader_2x03_P2.54mm_Vertical
J213: SD_conn; PinHeader_1x07_P2.54mm_Vertical
R220, R221: 10k; R_1206_3216Metric_Pad1.42x1.75mm_HandSolder
R222, R223, R224: 220; R_1206_3216Metric_Pad1.42x1.75mm_HandSolder
R225, R226, R227: 1k8; R_1206_3216Metric_Pad1.42x1.75mm_HandSolder
R228, R229, R230: 3k3; R_1206_3216Metric_Pad1.42x1.75mm_HandSolder
U200: ATmega32-16AU; TQFP-44_10x10mm_P0.8mm
U202: LM2936-3.3; SOT-223-3_TabPin2
Y200: 14,31818 MHz; Crystal_HC18-U_Vertical

Connections:
+3V3: C222.1, C230.1, C231.1, J203.4 (VDD), J213.3, U202.3 (VO)
+5VA: C232.1, C233.1, J204.2, R220.1, R221.1, R222.1, R223.1, R224.1, U200.5 (VCC), U200.17 (VCC), U200.27 (AVCC), U200.38 (VCC), U202.1 (VI); also elsewhere on the board
COMMAND: J205.6; also elsewhere on the board
DATA_IN: J205.2; also elsewhere on the board
DATA_OUT: J205.4; also elsewhere on the board
GND: C220.2, C221.2, C222.2, C225.1, C226.1, C227.1, C228.1, C229.1, C230.2, C231.2, C232.2, C233.2, J203.6 (VSS), J203.11 (VSS), J203.12 (Shield), J204.6, J209.2, J209.4, J209.6, J213.7, R228.1, R229.1, R230.1, U200.6 (GND), U200.18 (GND), U200.28 (GND), U200.29 (AREF), U200.39 (GND), U202.2 (GND); also elsewhere on the board
unnamed: C220.1, U200.8 (XTAL1), Y200.1
unnamed: C221.1, U200.7 (XTAL2), Y200.2
unnamed: C225.2, J208.5, U200.40 (PB0)
unnamed: C226.2, J208.4, U200.41 (PB1)
unnamed: C227.2, J208.3, U200.42 (PB2)
unnamed: C228.2, J208.2, U200.43 (PB3)
unnamed: C229.2, J208.1, U200.44 (PB4)
unnamed: D200.1 (K), U200.10 (PD1)
unnamed: D200.2 (A), J205.1, R221.2
unnamed: J203.2 (DAT3/CS), J213.5, R227.2, R228.2
unnamed: J203.3 (CMD/MOSI), J213.4, R226.2, R229.2
unnamed: J203.5 (CLK/SCK), J213.2, R225.2, R230.2
unnamed: J203.7 (DAT0/MISO), J213.1, U200.22 (PC3)
unnamed: J203.9 (COM), J213.6, U200.23 (PC4)
unnamed: J204.1, U200.2 (PB6)
unnamed: J204.3, U200.3 (PB7)
unnamed: J204.4, U200.1 (PB5)
unnamed: J204.5, R220.2, U200.4 (~RESET)
unnamed: J205.3, U200.9 (PD0)
unnamed: J205.5, U200.11 (PD2)
unnamed: J206.1, R222.2
unnamed: J206.2, U200.26 (PC7)
unnamed: J207.1, U200.37 (PA0)
unnamed: J207.2, U200.36 (PA1)
unnamed: J207.3, U200.35 (PA2)
unnamed: J207.4, U200.34 (PA3)
unnamed: J207.5, U200.33 (PA4)
unnamed: J207.6, U200.32 (PA5)
unnamed: J207.7, U200.31 (PA6)
unnamed: J207.8, U200.30 (PA7)
unnamed: J209.1, U200.14 (PD5)
unnamed: J209.3, U200.15 (PD6)
unnamed: J209.5, U200.16 (PD7)
unnamed: J211.1, R223.2
unnamed: J211.2, U200.25 (PC6)
unnamed: J212.1, R224.2
unnamed: J212.2, U200.24 (PC5)
unnamed: R225.1, U200.21 (PC2)
unnamed: R226.1, U200.20 (PC1)
unnamed: R227.1, U200.19 (PC0)

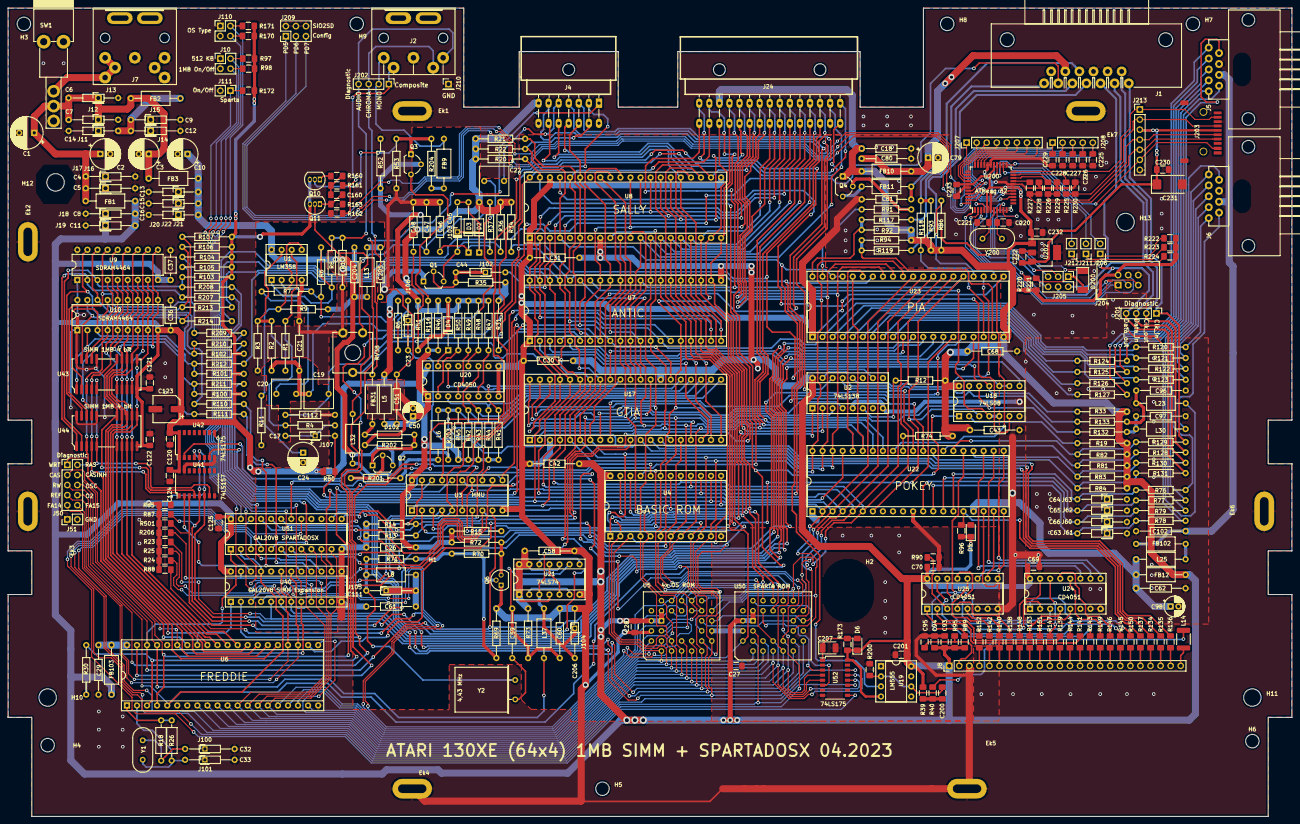
[picture p19: board Atari 130XE 1MB Sparta.kicad_pcb from above]

Board: 2 copper layers, 324.0 x 204.0 mm, 387 parts (0 on the bottom side), 334 nets.
